BrainCOGS/VRrigs-documentation/README.md

# BrainCOGS VR rigs documentation site
## Setting up a development environment
