BrainCOGS/VRrigs-documentation/index.md

---
layout: home
hero:
  name: BRAIN CoGS
  text: Mini VR Rigs
  tagline: How to build, maintain and run the mini virtual reality rigs at Princeton BRAIN CoGS.
  image:
    src: /images/braincogslogo.png
    alt: BRAIN CoGS
  actions:
    - text: Build a Rig
      link: /building/
      theme: brand
    - text: Maintenance
      link: /maintenance/
      theme: alt
    - text: Software
      link: /software/
      theme: alt
features:
  - icon: 🛠️
    title: Build a Mini VR Rig
    details: Parts lists, CAD files and step-by-step assembly for every module, from the cabinet to lick detection.
    link: /building/
    linkText: Start building
  - icon: 🔧
    title: Maintain a Mini VR Rig
    details: Calibrate the projection, reward and stage, and keep each module of the rig running.
    link: /maintenance/
    linkText: Maintenance guides
  - icon: 💻
    title: Software
    details: Database access, ViRMEn, the ephys/imaging automation pipeline, alerts and scheduled jobs.
    link: /software/
    linkText: Software guides
---
