BrainCOGS/VRrigs-documentation/software/automation_pipeline.md

---
title: Ephys/Imaging Automation Pipeline
lang: en-US
---

# {{ $frontmatter.title }}

## Data Folders

The ephys and imaging pipelines use the following data folder structures:

- **Raw Data Directory Imaging:** braininit/Data/Raw/imaging/(user)/(subject)/(session_date)_g(session#)/(user_defined_dir)
- **Processed Data Directory Imaging:** braininit/Data/Processed/imaging/(user)/(subject)/(session_date)_g(session#)/(user_defined_dir)/job_id_(jobid)/suite2p_output/suite2p
- **Raw Data Directory Ephys:** braininit/Data/Raw/electrophysiology/(user)/(subject)/(session_date)_g(session#)/(g#_spikeglx_dir)/(imec#_spikeglx_dir)
- **Processed Data Directory Ephys:** braininit/Data/Processed/electrophysiology/(user)/(subject)/(session_date)_g(session#)/(g#_spikeglx_dir)/(imec#_spikeglx_dir)/job_id_(jobid)/(sorter)_output

## Initial configuration

Note: These steps are only needed if a red label reading "Configuration needed" appears in the top-right corner of the GUI.

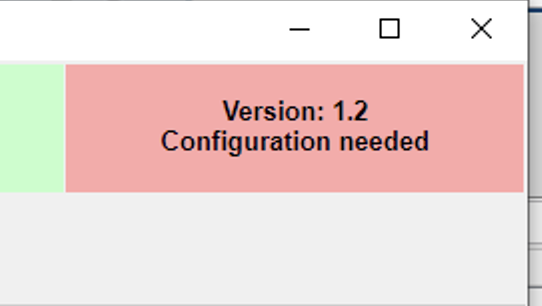
[picture p1: software/assets/images/automation_gui/Configuration_needed_label.png]
Configuration needed label
  

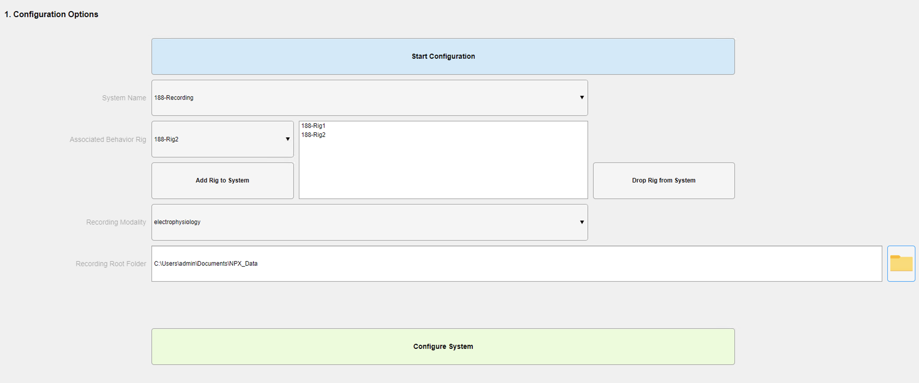
[picture p2: software/assets/images/automation_gui/Configuration_screen.png]
Configuration screen
  

1. Switch to the **"System Configuration"** tab.
2. Click the **"Start Configuration"** button.
3. In the **"System Name"** dropdown, select the corresponding system (normally named room#-Recording#).
4. In the **"Associated Behavior Rig"** dropdown, select the corresponding rig paired with the recording system.
5. Click the **"Add Rig to System"** button.
6. Repeat steps 4 and 5 until all rigs associated with the recording system are added.
7. In the **"Recording Modality"** dropdown, select the corresponding modality of the recording system.
8. In the **"Recording Root Folder"** area, click the folder button to search for the parent path where all recordings will be stored.
9. Click the **"Configure System"** button.

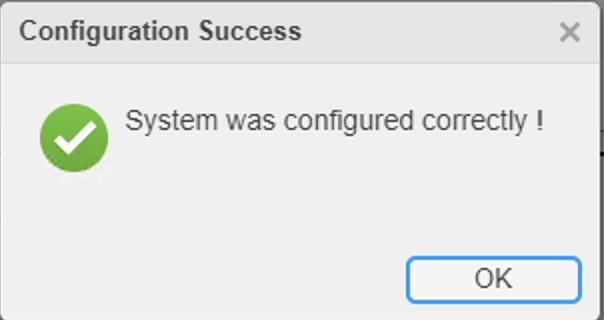
[picture p3: software/assets/images/automation_gui/System_configured_dialog.png]
System configured correctly
  

If something was configured incorrectly, you can repeat the entire process.

## Automation GUI "regular use" Manual

- The automation GUI is located on the desktop of every microscope/ephys recording system across BRAIN CoGS. You can identify it by the BRAIN CoGS desktop icon called "Recording_Automation_GUI".
- We encourage you to register and process every recording with the Automation GUI as soon as the recording ends.

### Default use case

1. Open the GUI as soon as the recording ends.
2. Select the recording directory from the dropdown list in section 1.
   - If no behavior is associated with this recording, uncheck the **Is there behavior Session for Recording** checkbox.
3. Check the "Add surgery & insertion device if missing" checkbox if you want to add electrode/microscope/optic fiber insertion coordinates.
4. Select the behavior session corresponding to the recording from the dropdown list in section 2.
5. Click the **Register Recording** button.

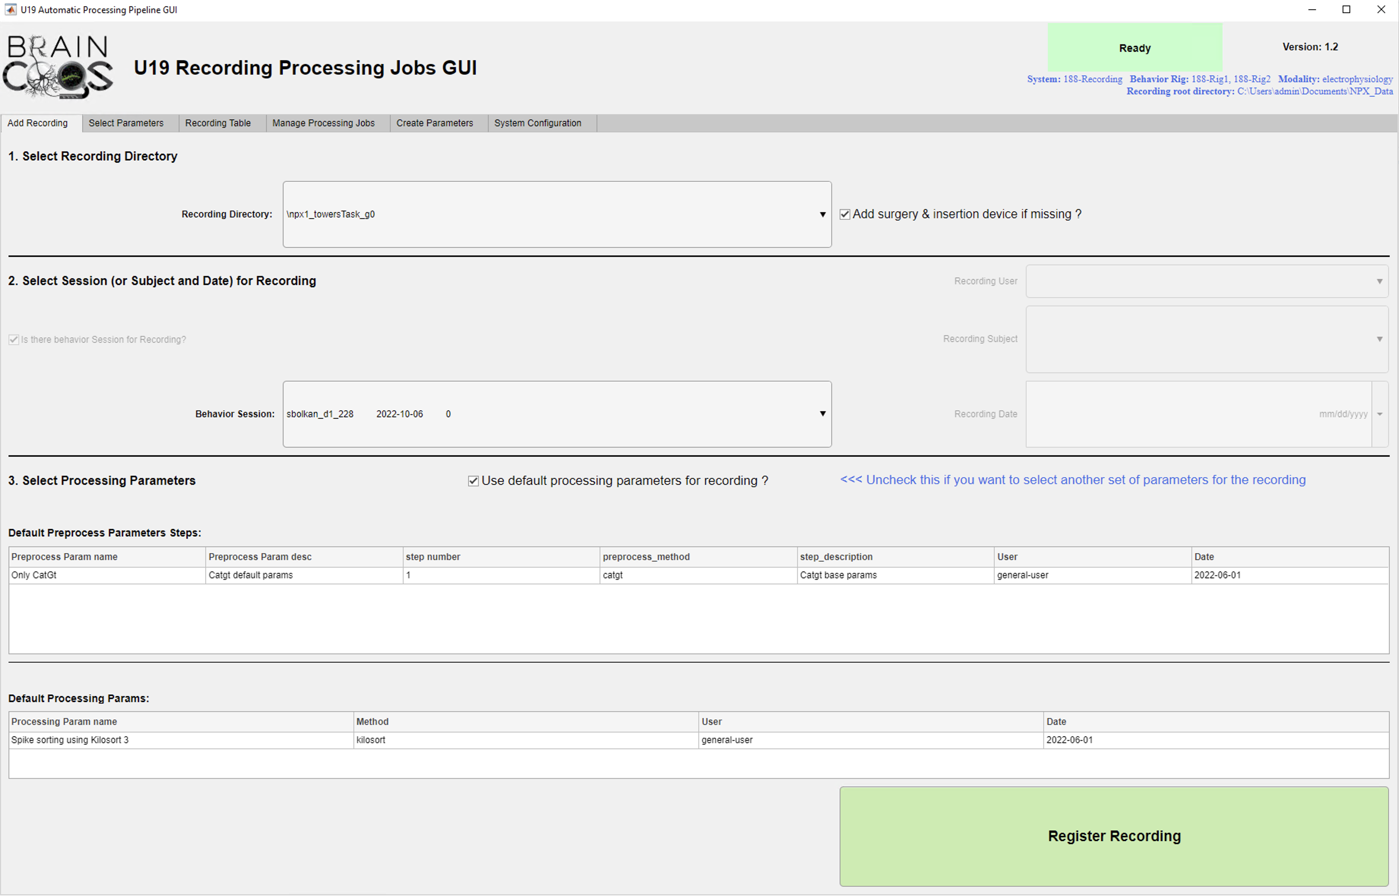
[picture p4: software/assets/images/automation_gui/Automation_GUI_main_screen.png]
Automation GUI main screen
  

- If no surgery data is found for the subject, a small form for entering surgery and device insertion coordinates appears.

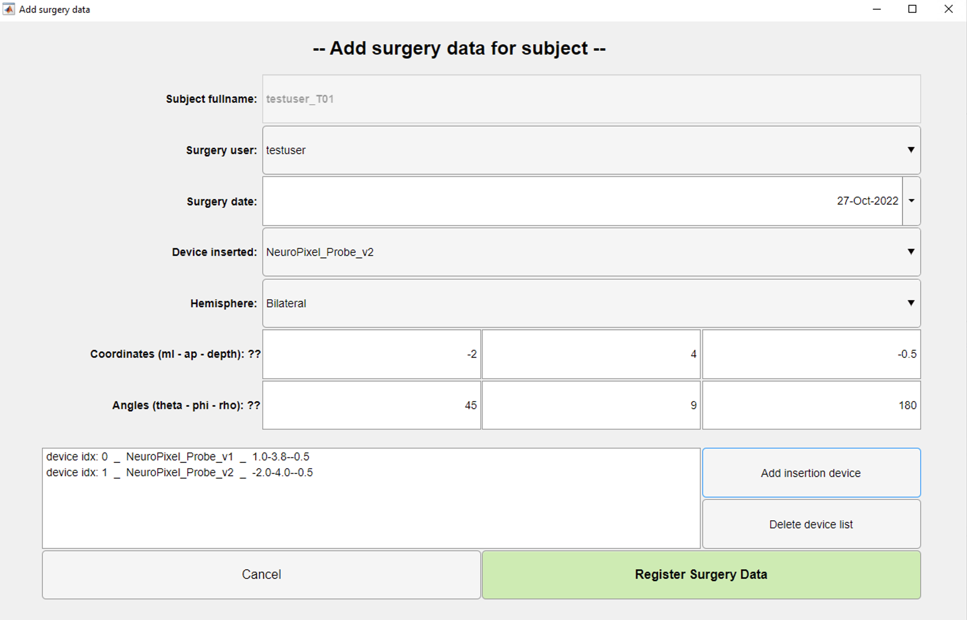
[picture p5: software/assets/images/automation_gui/Add_surgery_data.png]
Add surgery data form
  

- Common coordinates for previous recordings:

| **Area** | ml(mm) | ap(mm) | depth(mm) | theta(°) | phi(°) | rho(°) |
|---:|---:|---:|---:|---:|---:|---:|
| **mPFC L HEMIS** | -0.6 | 1.8 | 3.8 | -45 | -9 | 180 |
| **mPFC R HEMIS** | 0.6 | 1.8 | 3.8 | 45 | 9 | 0 |
| **HPC  L HEMIS** | -1.5 | 2 | 1.8 | -45 | -9 | 180 |
| **HPC  R HEMIS** | 1.5 | 2 | 1.8 | 45 | 9 | 0 |

- Wait until the recording has been copied to PNI storage resources (cup).

  Dialog shown while copying session

6. After the recording has been transferred, a small dialog showing the recording ID appears.

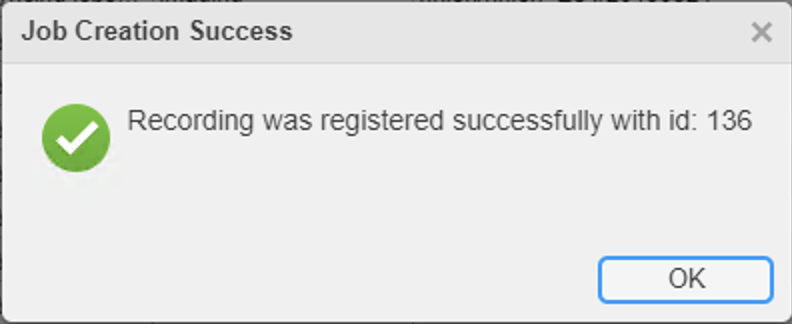
[picture p6: software/assets/images/automation_gui/Recording_registered.png]
Dialog shown when recording has been transferred
  

7. You can check basic info about the new recording in the "Recording Table" tab. This tab becomes active after the recording is transferred.

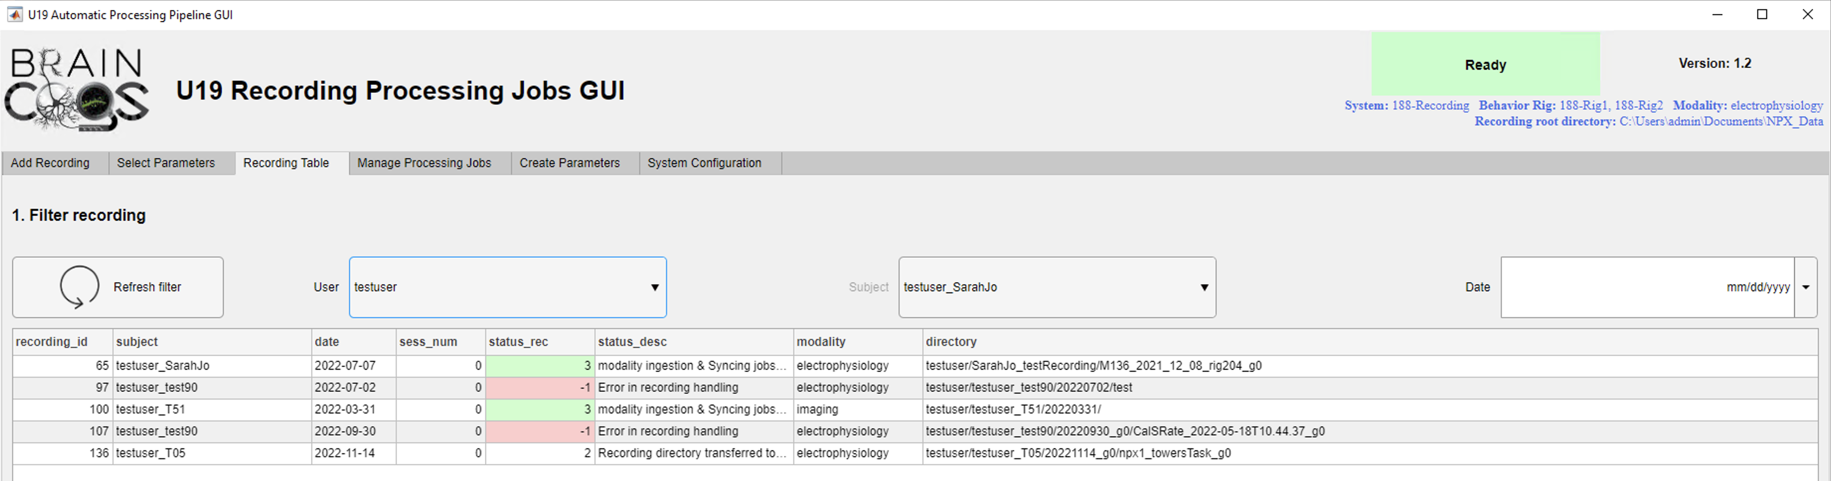
[picture p7: software/assets/images/automation_gui/Recording_table.png]
Recording table tab screenshot
  

#### Notes

- This use case assumes the recording will be processed with default parameters.

## "Advanced" (select parameters) use case

1. Follow steps 1-4 from the **Default use** case.
2. Uncheck the **"Use default processing parameters for recording?"** checkbox.
3. Click the **"Select parameters >>>"** button.

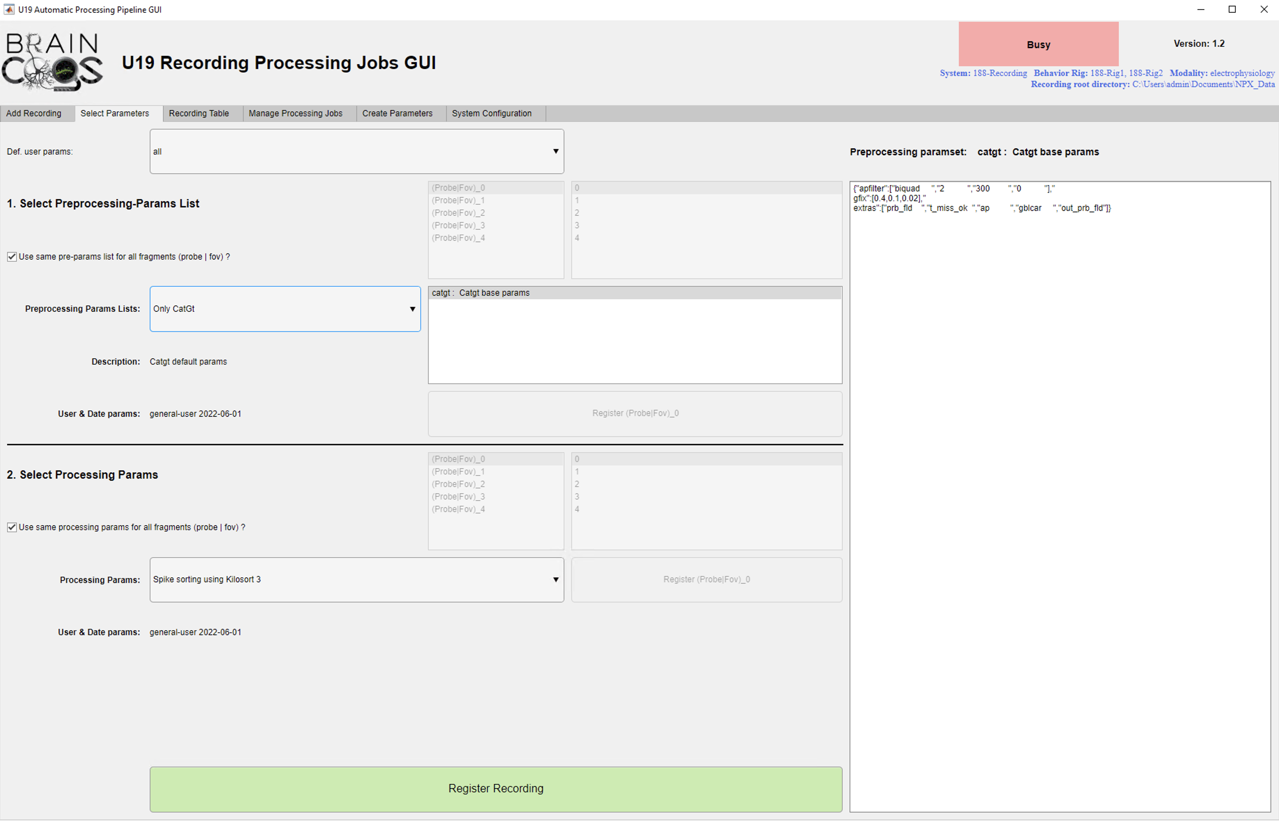
[picture p8: software/assets/images/automation_gui/Select_parameters.png]
Parameter selection main screen
  

4. On the **"Select parameters"** tab (assuming all probes/FOVs will be processed with the same parameters):

### On section 1:

5. In the **Preprocessing Params Lists** dropdown, select a preprocessing param list.
   - You can see which preprocessing steps are defined for that list in the listbox on the right.
   - Selecting a preprocessing step in the listbox shows its specific parameters in the text area on the right.

### On section 2:

6. In the **Processing Params** dropdown, select a processing parameter set suited to the recording.
   - Selecting a processing parameter set from the dropdown shows its specific parameters in the text area on the right.
7. Click the **Register Recording** button.

The next steps are identical to the **"Default use"** case.

## Monitor jobs

- After a recording is submitted for processing, you can track, reprocess, and visualize all jobs corresponding to that recording.

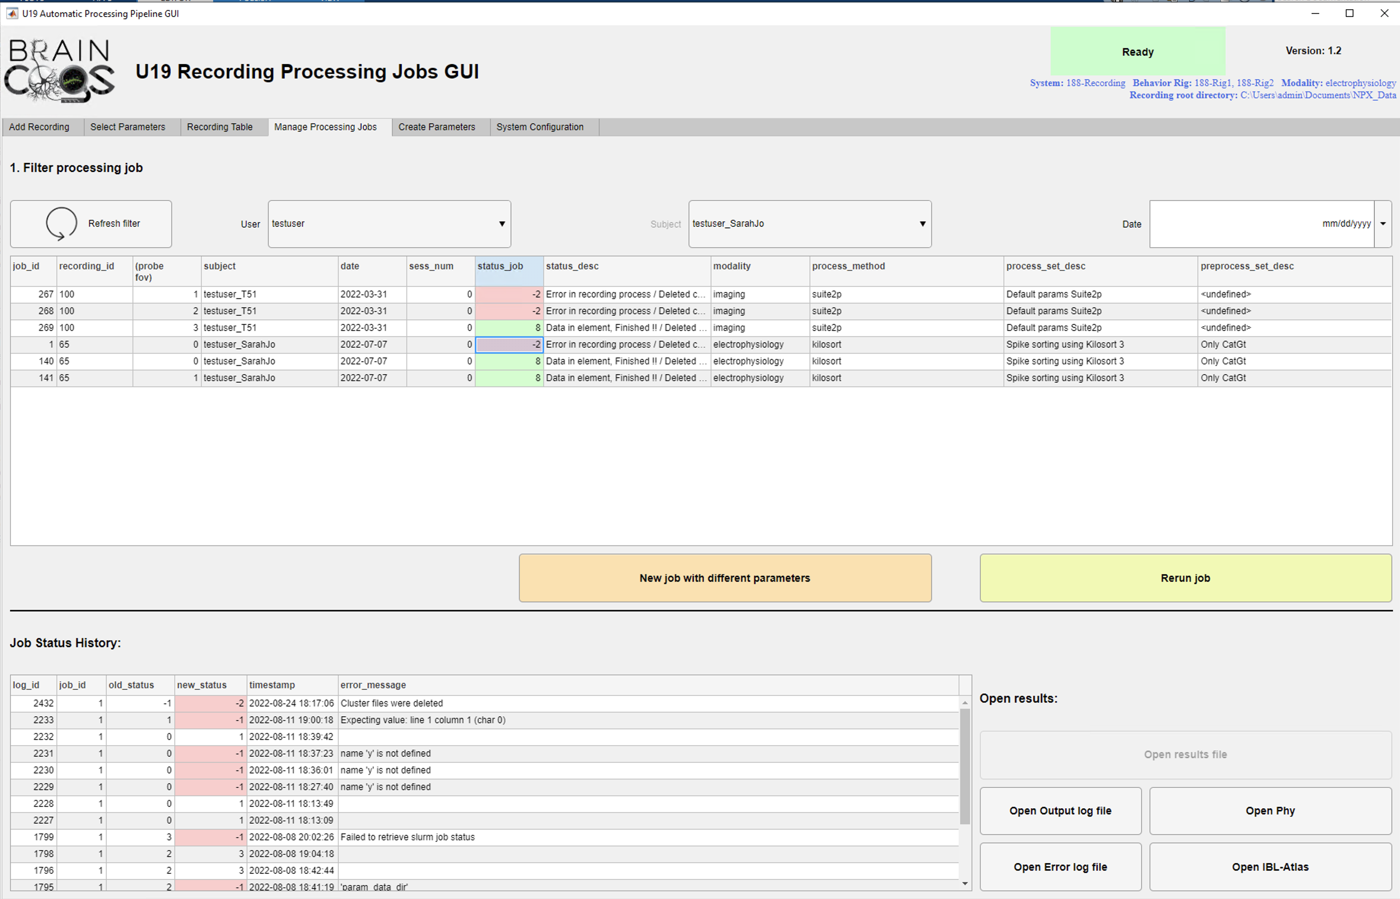
[picture p9: software/assets/images/automation_gui/Job_table.png]
Manage Processing Jobs main screen
  

### Track status

1. Switch to the **"Manage Processing Jobs"** tab.
2. Use the **"User"**, **"Subject"**, and **"Date"** dropdowns/fields to find the desired jobs.
3. Select the row corresponding to the desired job:

- The job status history is shown for the selected job.

#### If the job is in an error status (-1, -2; "Error in recording process"): {#if-status-of-job-is-in-error-status-1-2-error-in-recording-process}

- Open the error log file in the bottom-right corner by clicking the **"Open Error Log File"** button.
- If you believe the cause of the error is now resolved, rerun the job by clicking the **"Rerun job"** button.

#### If the job is in a finished status (7, 8; "Data in element DB"): {#if-status-of-job-is-in-finished-status-7-8-data-in-element-db}

- Open the output log file in the bottom-right corner by clicking the **"Open Output Log File"** button.
- Visualize processing results by clicking the bottom-right buttons: **Open Phy** and **Open IBL Atlas** for ephys, **Open Suite2p-GUI** for imaging.

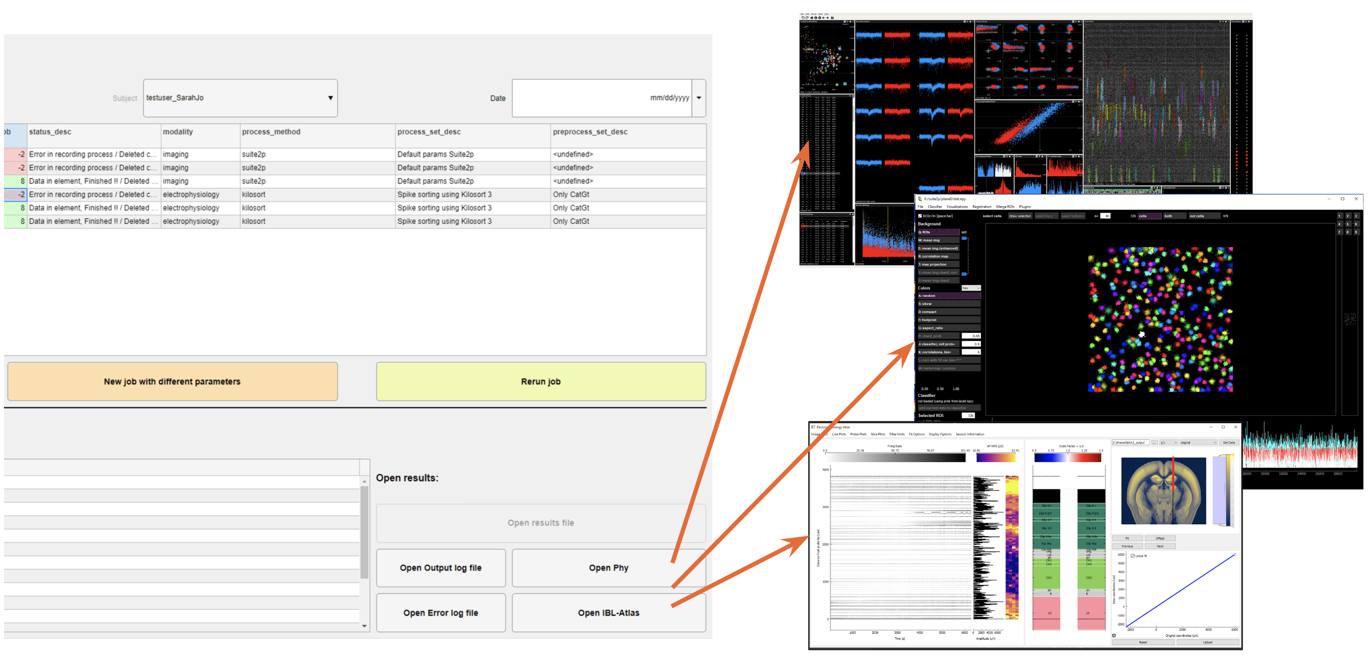
[picture p10: software/assets/images/automation_gui/Processing_visualization.png]
Visualization tools available
  

#### Rerun jobs

- You can rerun a job with different parameters by clicking the **New Job With different Parameters** button.
- Follow the <a href='/software/automation_pipeline.html#advanced-select-parameters-use-case'> "Advanced" (select parameters) use case </a>.

## Create new sets of processing parameters for recordings

To process recordings with non-default parameters, you need at least one of the following:

1. A new set of processing parameters (parameters for the algorithm that processes the data, e.g. Kilosort, Suite2p).
2. A list of preprocessing steps, each with its own set of preprocessing parameters (e.g. run CatGT + TPrime before Kilosort).

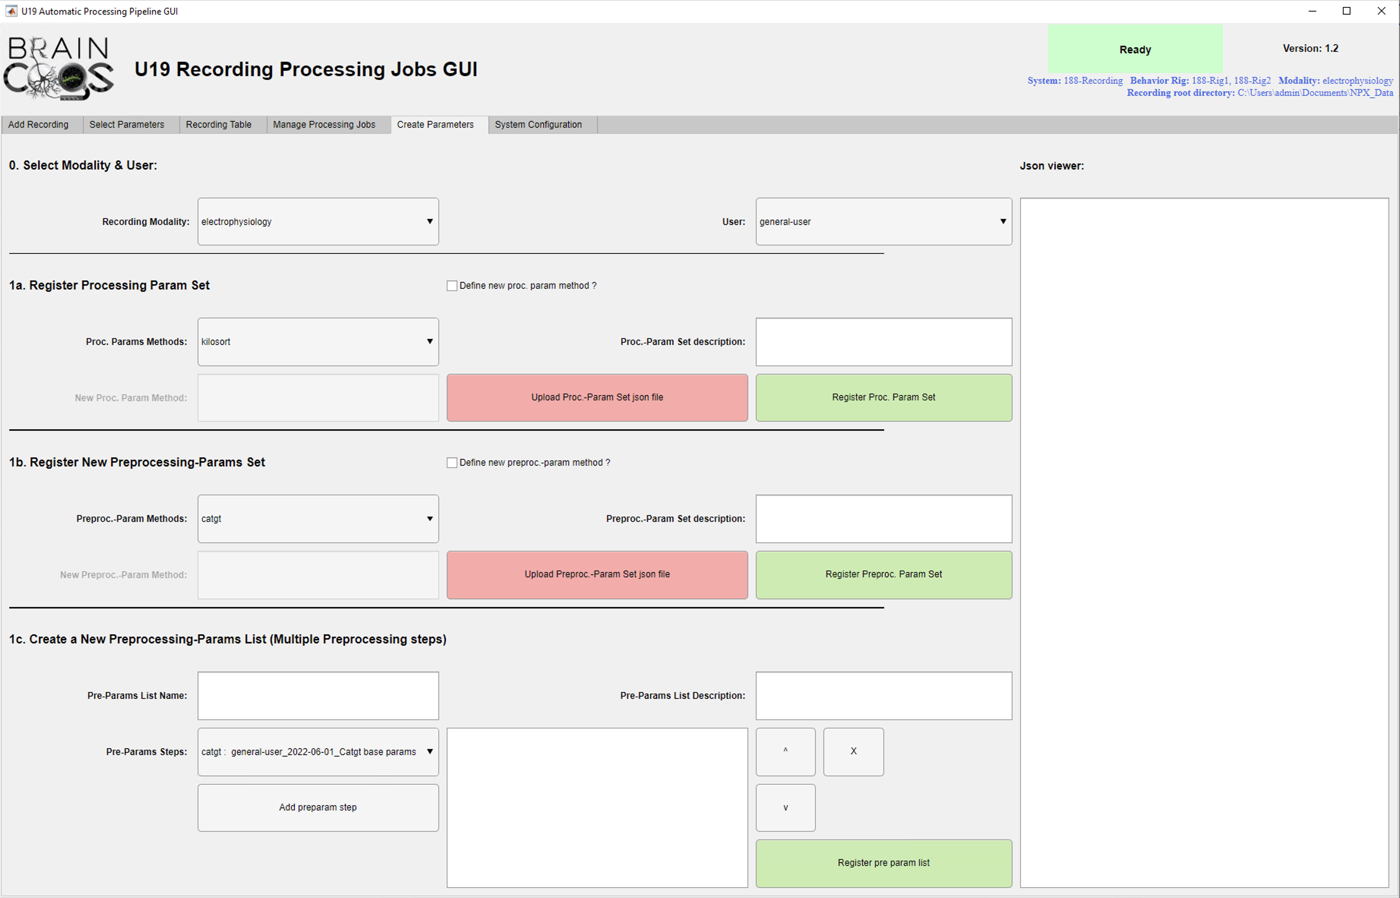
[picture p11: software/assets/images/automation_gui/Create_parameters_screen.png]
Create parameters screen
  

### Create new Processing parameters (algorithm params)

- Note: You need a JSON file with all parameters ready before starting this process.
- <a href='./assets/files/automation_gui/kilosort_parameters_example.json.zip'>Here</a> is an example Kilosort parameter JSON file that you can use as a template for your own.

1. Switch to the "Create Parameters" tab.

#### On section 0:

2. In the "recording modality" dropdown, select which modality the parameters correspond to.
3. In the "user" dropdown, select your NETID username (select general-user if this parameter will be shared by many users).

#### On section 1a:

4. In the "proc. Param Method" dropdown, select which method (algorithm) these parameters refer to.

##### If the algorithm is not found on "proc. Param Method" dropdown:

- Check the "define new proc. param method ?" checkbox.
- Write the new processing method name in the "New Proc. Param. method" field.
- Check the <a href='/software/automation_pipeline_developer.html#collab-repositories-to-handle-ephys-imaging-processing'>automation pipeline developer guide</a> to add the corresponding processing code.

5. In the "proc. Param Set Description" field, write a short description for the new parameters.
6. Click the "Upload Proc-Parm Set json file" button and browse for/load your JSON file with parameters. You can review your parameters in the text area on the right.
7. Click the "Register Proc. Param Set" button.

### Create new preprocessing parameters (a single step on preprocessing list)

- Note: You need a JSON file with all parameters ready before starting this process.
- <a href='./assets/files/automation_gui/catgt_parameters_example.json.zip'>Here</a> is an example CatGT parameter JSON file that you can use as a template for your own.

1. Switch to the "Create Parameters" tab.

### On section 0:

2. In the "recording modality" dropdown, select which modality the parameters correspond to.
3. In the "user" dropdown, select your NETID username (select general-user if this parameter will be shared by many users).

### On section 1b:

4. In the "Preproc.-Param Method" dropdown, select which method (tool) these parameters refer to.

#### If the tool is not found on "Preproc.-Param Method" dropdown:

- Check the "define new prerproc.-param method ?" checkbox.
- Write the new preprocessing method name in the "New Preproc.-Param method" field.
- Check the <a href='/software/automation_pipeline_developer.html#collab-repositories-to-handle-ephys-imaging-processing'>automation pipeline developer guide</a> to add the corresponding processing code.

5. In the "Preproc.-Param Set Description" field, write a short description for the new parameters.
6. Click the "Upload Preproc.-Parm Set json file" button and browse for/load your JSON file with parameters. You can review your parameters in the text area on the right.
7. Click the "Register PreProc. Param Set" button.

### Create new preprocessing parameters list (a set of preprocessing parameters)

- Note: If you just created a preprocessing parameter, restart the GUI.

1. Switch to the "Create Parameters" tab.

### On section 0:

2. In the "recording modality" dropdown, select which modality the parameters correspond to.
3. In the "user" dropdown, select your NETID username (select general-user if this parameter will be shared by many users).

### On section 1c:

4. In the "Pre-Params List Name" field, enter a suitable name for the list.
5. In the "Pre.-Param List Description" field, write a short description for the new list.
6. From the "Pre.-Params steps" dropdown, select the desired preprocessing step to add to the list.
7. Click the "Add Preparam Steps" button.
8. Repeat steps 6 and 7 to add all desired preprocessing steps to the list.
9. Use the "v" and "^" buttons to set the order of the preprocessing steps.
10. Use the "x" button to delete an unwanted preprocessing step.
11. Click the "Register pre param list" button.
