BrainCOGS/VRrigs-documentation/software/manipulation_pipeline.md

---
title: Manipulation pipeline
lang: en-US
---

# {{ $frontmatter.title }}

+ This guide walks researchers through creating a new manipulation pipeline.
+ At BRAIN CoGS, optogenetic and thermal manipulations are currently supported.

## What does the “manipulation” pipeline include? {#what-does-the-manipulation-pipeline-include}

+ A minimal data framework for storing all relevant data from a specific manipulation in a DB.
+ Behavior integration: the training system includes the manipulation as an option that can be selected for a behavior session.
+ Generic software parameters to be used in behavior code.

## Prerequisites

+ To create a new manipulation, you need to:
  + be able to connect to the <a href="/software/db_access.html#db-access-for-matlab-repository">datajoint00.pni.princeton.edu DB</a>, and
  + have the latest version of the U19-pipeline-matlab repository installed.

## Initial setup {#initial-set-up}

+ Connect to the database: `connect_datajoint00`
+ Create the new manipulation schema (replace `manipulation_name` with the actual manipulation name): `create_new_manipulation_schema('(manipulation_name)', 1)`
+ This creates the "base" code for the new schema in the `U19-pipeline-matlab/schemas` directory.
+ (We use the “thermal” manipulation as the example.)

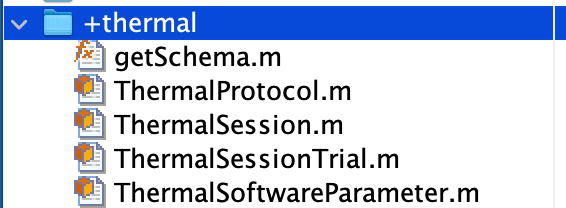
[picture p33: software/assets/images/manipulation_pipeline/Thermal_schema_files.png]
 

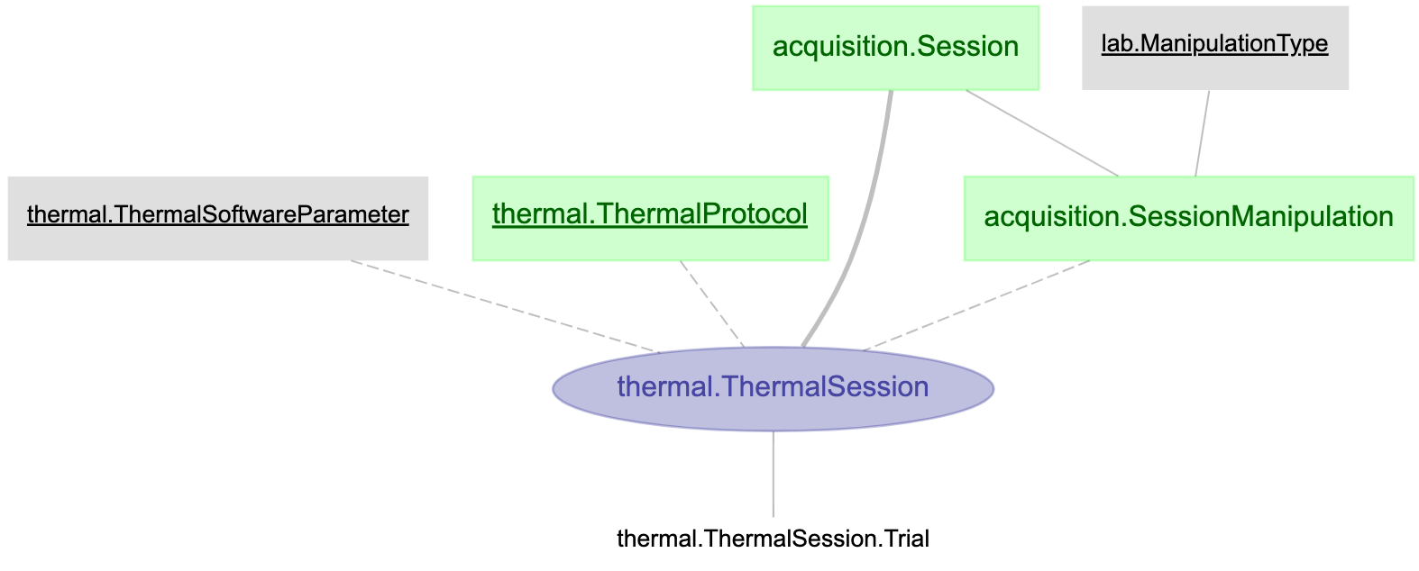
[picture p34: software/assets/images/manipulation_pipeline/Thermal_pipeline_ERD.png]
Thermal manipulation file creation & Entity-Relationship diagram on the BRAIN CoGS DB
 

## Table description

+ Throughout this section, we use an existing, working manipulation pipeline (optogenetics) as the example.

### "Manipulation" Protocol table

  + The Protocol table stores information that defines the current manipulation “type” to be used in a behavior session.
  + Below is the minimal definition of a manipulation protocol table: an id that identifies the protocol, and a description field.

  + Generic **"Manipulation" Protocol.m**
  ```matlab
  %{
  # Defined <manipulation> protocols for training
  <manipulation>_protocol_id     : int AUTO_INCREMENT
  ---
  protocol_description        : varchar(256)  
  %}
  ```

### Adding features to "Manipulation" Protocol table

+ For each manipulation protocol, you can add from 0 to n “features” that define and describe the protocol. As an example, we describe all the features added for **OptogeneticsProtocol**:

+ For an optogenetic experiment, it is important to know what kind of stimulation was given to the subject: frequency, wavelength, power, etc. All these variables can be stored in a “feature” table and categorized as StimulationParameters.
+ What if the stimulation was not a square pulse? We can create a “feature” table to define specific waveforms for a given session, if needed (OptogeneticsWaveform).
+ What if different rooms have different laser system models? We can create a “feature” table to store all the possible devices used in an optogenetic experiment (OptogeneticsDevice).
+ For each of these features, we need to create a new table that holds the information needed for that feature. We call all these extra tables protocol “feature” tables.
+ For a guide on how to define DJ tables, see <a href="https://docs.datajoint.org/matlab/definition/02-Creating-Tables.html">this link</a>.

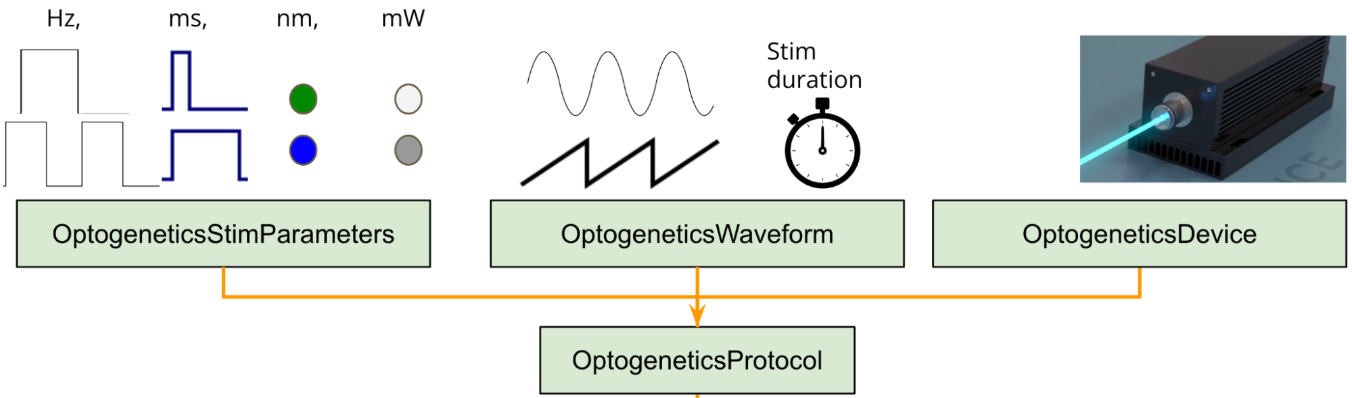
[picture p35: software/assets/images/manipulation_pipeline/Optogenetics_pipeline.png]
Tables that define an optogenetic protocol for a session.
 

+ For this guide, we show only the OptogeneticsStimulationParameters definition as an example:

### OptogeneticsStimulationParameters.m:
 ```matlab
  %{
  # Parameters related to laser stimulation
  stim_parameter_set_id       : int AUTO_INCREMENT  #
  ---
  stim_parameter_description  : varchar(256)        #
  stim_wavelength             : decimal(5,1)        # (nm)
  stim_power                  : decimal(4,1)        # (mW)
  stim_frequency              : decimal(6,2)        # (Hz)
  stim_pulse_width            : decimal(5,1)        # (ms)
  %}

  classdef OptogeneticStimulationParameter < dj.Lookup
    properties
    end
  end
  ```

+ Fields needed for a protocol “feature” table:

+ **id field:** An int AUTO_INCREMENT type as the only primary key (e.g. stim_parameter_set_id).
+ **extra_fields:** Any other field that helps define the feature.
+ Once all the feature tables are defined, they should be added to the "Manipulation" Protocol table.

+ For our Optogenetics example:
 ```matlab
 % Declare new "feature" table
 optogenetics.OptogeneticsStimulationParameters
 % Add the feature -> protocol table
 add_feature_key_protocol_table(optogenetics.OptogeneticsProtocol, ... optogenetics.OptogeneticsStimulationParameters)
 % Sync definition from DB to .m file
 syncDef(optogenetics.OptogeneticsProtocol);
 % clear previous connection and connect again
 clear all
 connect_datajoint00
 ```

+ Once the “feature” tables are added to the "Manipulation" Protocol table, we are ready to add protocols so they are “ready” and selectable for a behavior session:

```matlab
 % Insert stim parameter record
 stim_parameter_rec.stim_parameter_description = 'cool stims'
 stim_parameter_rec.stim_wavelength = 473
 stim_parameter_rec.stim_power = 10  
 stim_parameter_rec.stim_frequency = 100  
 stim_parameter_rec.stim_pulse_width = 1
 insert(optogenetics.OptogeneticsStimulationParameters, stim_parameter_rec)  

 % get last inserted stim_id
 stim_id = fetch(optogenetics.OptogeneticsStimulationParameters, 'ORDER BY stim_parameter_set_id desc LIMIT 1');

 % or look for a previously inserted parameter
 all_stim_params = fetch(optogenetics.OptogeneticsStimulationParameters, '*')
 stim_id = 1;

 % Insert new protocol with new stimulation parameter
 new_protocol.protocol_description = 'this_is_new_protocol'
 new_protocol.stim_parameter_set_id = stim_id;
 insert(optogenetics.OptogeneticsProtocol, new_protocol)
```  

### "Manipulation" SoftwareParameters table

+ The SoftwareParameters table stores a set of parameters (a MATLAB struct or a Python dictionary) that the code handling the behavior uses during the session.
+ Below is how to insert new software parameters into the **optogenetics.OptogeneticSoftwareParameter** table.

 ```matlab
 param_struct = struct();
 param_struct.software_parameter_description =  'stimulation_sequence # 1';

 % All parameters goes in here
 %(P_on and lsrepoch are the common and needed for current opto experiments)
 param_struct.software_parameters.P_on      = 0.21;
 param_struct.software_parameters.lsrepoch  = 'cue';

 %Insert parameter
 software_param_id = try_insert(optogenetics.OptogeneticSoftwareParameter, param_struct)
 ```

+ See the <a href="https://github.com/BrainCOGS/U19-pipeline-matlab/blob/master/scripts/insert_software_parameters/insert_optogenetic_software_parameter.m">insert_optogenetic_software_parameter</a> script to use as an example.
+ To read the software parameters in the ViRMEn experiment code, for example in `initializationCodeFun`:

 ```matlab
 function vr = initializationCodeFun(vr)

 vr.software_params     = vr.exper.userdata.trainee.softwareParams.software_parameters;
 vr.lsrepoch = vr.software_params.lsrepoch;
 vr.P_on = vr.software_params.P_on;
 ```

### "Manipulation" Session table

+ This table stores manipulation data for a specific behavior session. It “links” a manipulation protocol and manipulation software parameters to a behavior session.
+ This table does not need any additional code (unless extra fields from the behavior file need to be stored). **If you need that, contact the DB designer.**

 ```matlab
 OptogeneticSession.m
 %{
 # Information of a optogenetic session
 -> acquisition.Session
 ---
 -> acquisition.SessionManipulation
 -> optogenetics.OptogeneticProtocol
 -> optogenetics.OptogeneticSoftwareParameter
 %}
 ```

### "Manipulation" SessionTrial table

+ This table stores data, on a trial-by-trial basis, corresponding to the manipulation performed during the behavior session.
+ Every "Manipulation" SessionTrial class has a section in its `get_manipulation_trial_data` function where the researcher adds the lines that fetch the manipulation data for each trial:

Code extract from the **OptogeneticSessionTrial** table:

```matlab
function trial_structure = get_manipulation_trials_data(~,session_key, log)
.
.
for itrial = 1:nTrials

  curr_trial = log.block(iBlock).trial(itrial);  
  trial_data = session_key;
  trial_data.stim_on           = curr_trial.lsrON;
  trial_data.t_stim_on  = time_trial(curr_trial.iLaserOn);
  trial_data.stim_epoch = num2str(curr_trial.LaserTrialType);
  trial_structure(total_trials) = trial_data;
```

### Training with a new manipulation {#training-with-new-manipulation}

+ Once all the code for the new manipulation has been set up, the researcher can select the manipulation type, protocol and software parameters in an animal's training schedule, and subsequent behavior sessions will use them.

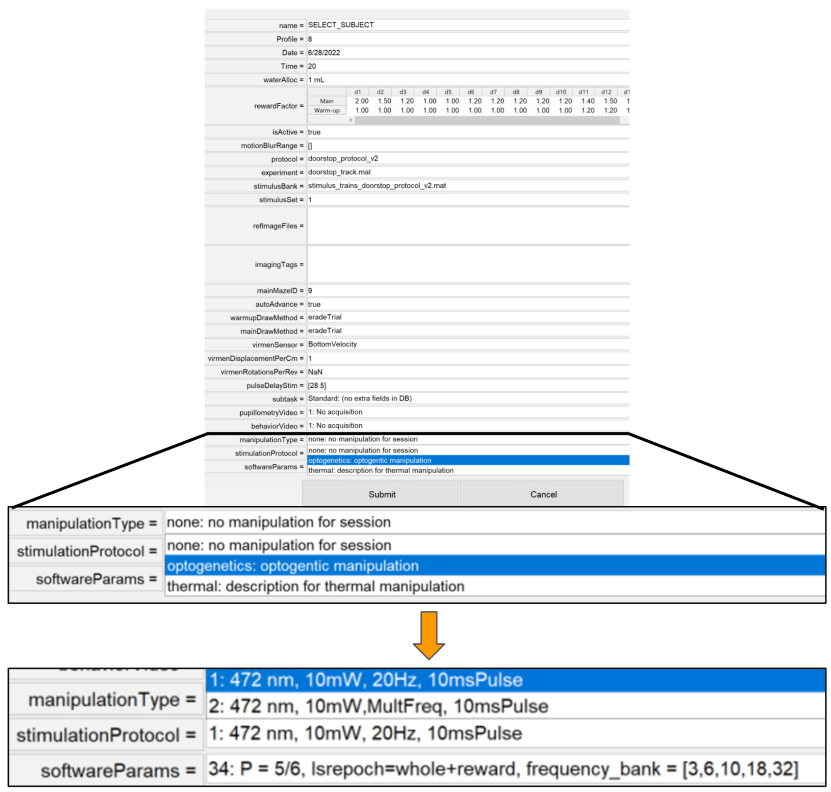
[picture p36: software/assets/images/manipulation_pipeline/manipulation_trainingGUI.png]
Parameter selection (manipulation, protocol & software parameters) for a training schedule of a subject.


### Fetching data {#fetching-data}

+ After training, all relevant data is available in the corresponding tables of the database.
+ <a href="https://docs.datajoint.org/matlab/queries/03-Fetch.html">DataJoint fetch guide</a>

```matlab
key = struct('subject_fullname', 'sbolkan_a2a_492', 'session_date', '2022-06-27')
fetch(optogenetics.OptogeneticSessionTrial * optogenetics.OptogeneticSession & key,'*')

ans =

  363×1 struct array with fields:

    subject_fullname
    session_date
    session_number
    block
    trial_idx
    stim_on
    t_stim_on
    t_stim_off
    stim_epoch
```
