BrainCOGS/VRrigs-documentation/building/assets/3d-printing/positioning/positioning_tool_mini_vr.stp

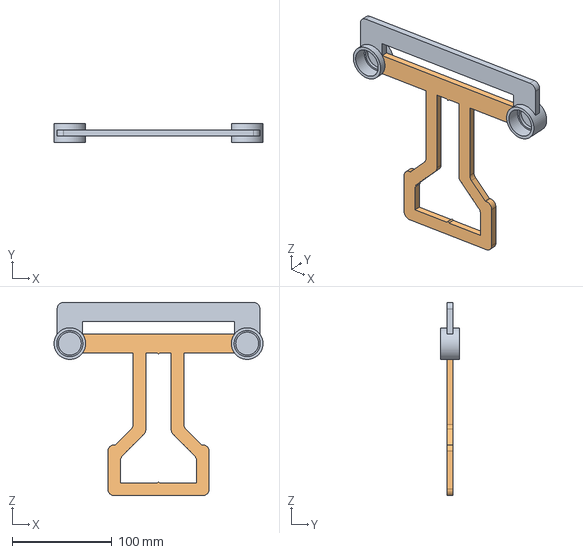
[picture p42: CAD file, 2021-09-08]
building/assets/3d-printing/positioning/positioning_tool_mini_vr.stp
209.5 x 19.0 x 193.6 mm
