BrainCOGS/VRrigs-documentation/(list of files, cad)

Other CAD files:
building/assets/drawings/src/air-puffs/Air puffs delivery.iam
building/assets/drawings/src/air-puffs/Air puffs.iam
building/assets/drawings/src/air-puffs/Control manifold.iam
building/assets/drawings/src/air-puffs/Parts/1162T370_ZINC PLATED STEEL FITTINGS WITH SEALANT.ipt
building/assets/drawings/src/air-puffs/Parts/2227T21_Miniature Precision Compressed Air Regulator.ipt
building/assets/drawings/src/air-puffs/Parts/2227T41_Mounting Bracket for Inline Mount 1 8 NPT Miniature Precision Compressed Air Regulator.ipt
building/assets/drawings/src/air-puffs/Parts/2227T420_PRECISION NPT THREAD MINIATURE AIR REGULATOR.ipt
building/assets/drawings/src/air-puffs/Parts/2844K110_NICKEL-PLTD BRASS BARBED VACUUM TUBE FITTING.ipt
building/assets/drawings/src/air-puffs/Parts/5047K110_MOISTURE-RESISTANT ACETAL BARBED TUBE FITTING(1).ipt
building/assets/drawings/src/air-puffs/Parts/5648K266_POLYURETHANE TUBING FOR WATER.ipt
building/assets/drawings/src/air-puffs/Parts/5779K115_PUSH-TO-CONNECT TUBE FITTING FOR AIR.ipt
building/assets/drawings/src/air-puffs/Parts/5779K117_PUSH-TO-CONNECT TUBE FITTING FOR AIR.ipt
building/assets/drawings/src/air-puffs/Parts/8961K106_MOUNTING ADAPTERS FOR DIN RAIL(1).ipt
building/assets/drawings/src/air-puffs/Parts/91771A919_Passivated 18-8 Stainless Steel Phillips Flat Head Screw.ipt
building/assets/drawings/src/air-puffs/Parts/Manifold for gems solenoid valve vertical.ipt
building/assets/drawings/src/air-puffs/Parts/air puffs delivery cover.ipt
building/assets/drawings/src/air-puffs/Parts/air puffs delivery.ipt
building/assets/drawings/src/positioning/Parts/5862K163_HIGH-PULL RARE EARTH MAGNETIC DISC.ipt
building/assets/drawings/src/positioning/Parts/98535A136_1095 SPRING STEEL MACHINE KEY STOCK.ipt
building/assets/drawings/src/positioning/Parts/Positioning tool mini VR.ipt
building/assets/drawings/src/positioning/Positioning tool mini VR.iam
building/assets/drawings/src/reward/Parts/4406T110_MINIATURE STAINLESS STEEL BARBED TUBE FITTING.ipt
building/assets/drawings/src/reward/Parts/51525K428_PLASTIC QUICK-TURN TUBE COUPLING.ipt
building/assets/drawings/src/reward/Parts/91251A194_Black-Oxide Alloy Steel Socket Head Screw.ipt
building/assets/drawings/src/reward/Parts/Stainless steel tube.ipt
building/assets/drawings/src/reward/Parts/Syringe Needle, With Luer - White-17Gauge.ipt
building/assets/drawings/src/reward/Parts/TR2-Step.ipt
building/assets/drawings/src/reward/Parts/TRB1-Step.ipt
building/assets/drawings/src/reward/Parts/Tube to TRB1 adapter.ipt
building/assets/drawings/src/reward/Reward spout.iam
