BrainCOGS/VRrigs-documentation/building/assets/images/air-puffs/air-puffs-delivery.png

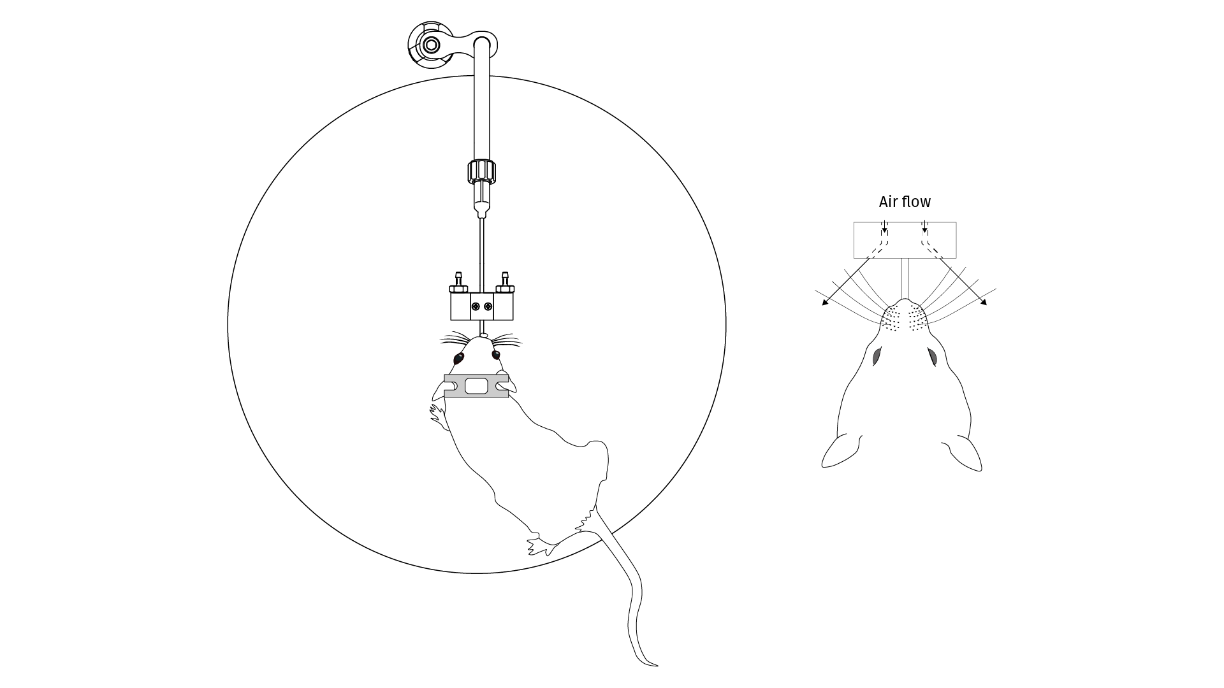
building/assets/images/air-puffs/air-puffs-delivery.png
