BrainCOGS/VRrigs-documentation/building/assets/images/air-puffs/air-puffs-description.png

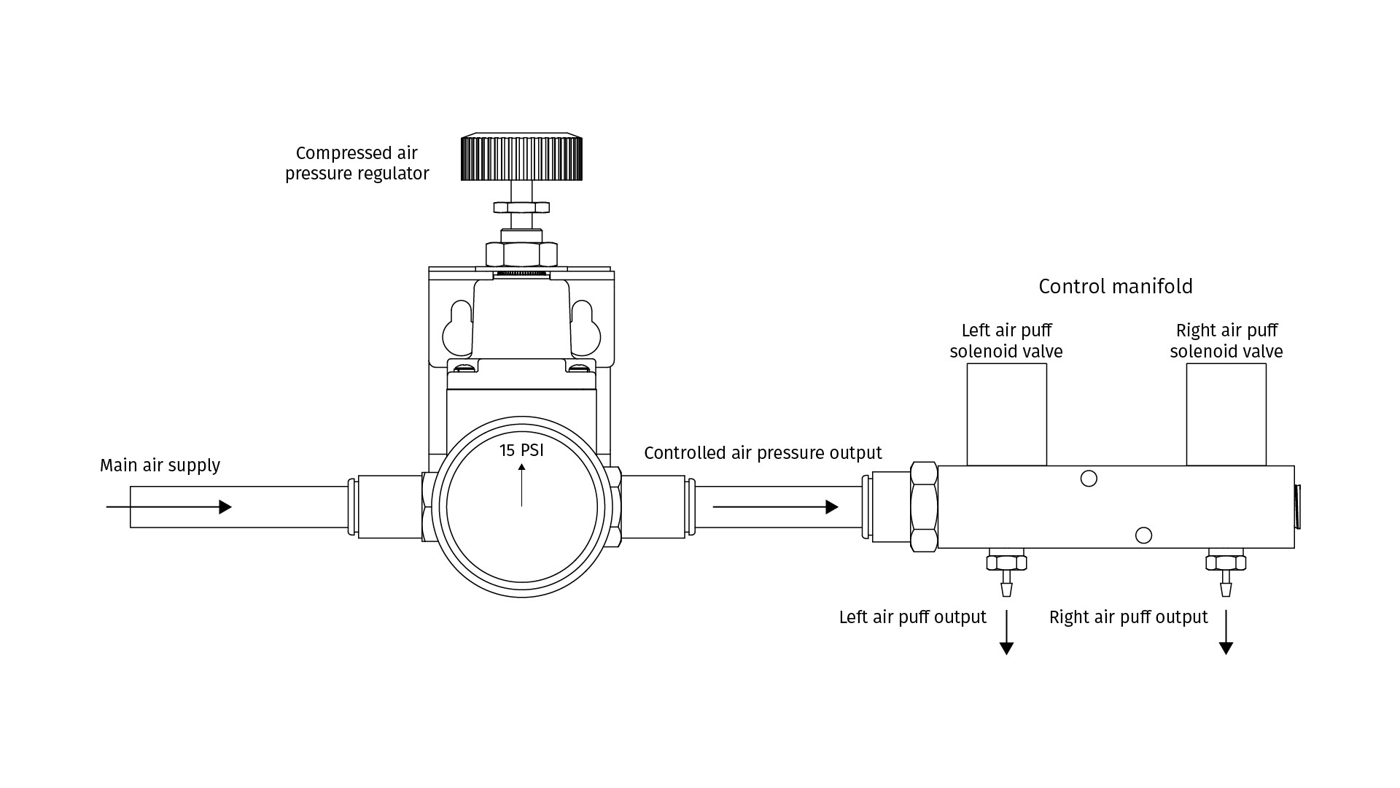
building/assets/images/air-puffs/air-puffs-description.png
