BrainCOGS/VRrigs-documentation/building/assets/images/positioning/positioning-assembly-1.png

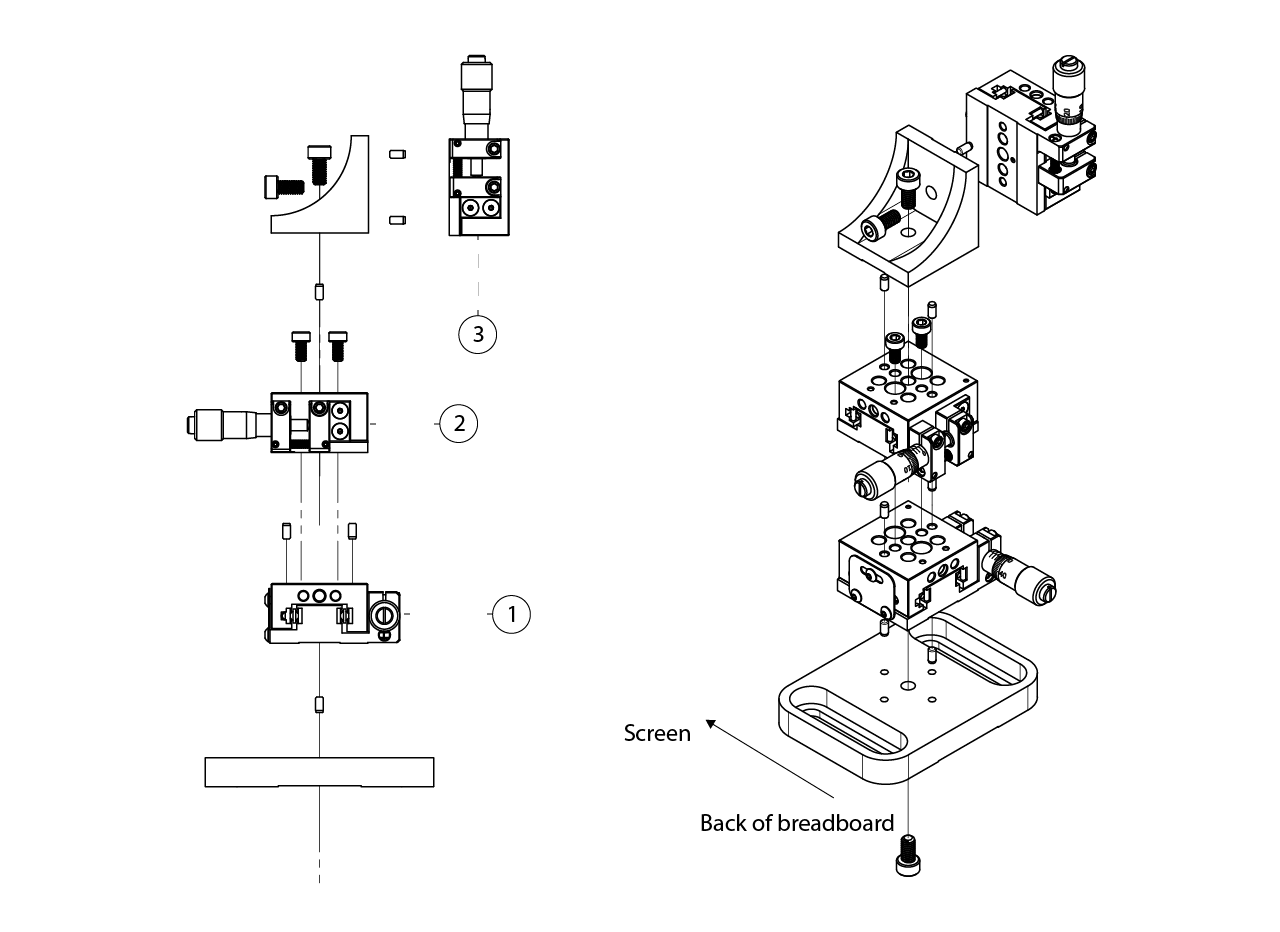
building/assets/images/positioning/positioning-assembly-1.png
