BrainCOGS/VRrigs-documentation/building/assets/images/positioning/positioning-assembly-2.png

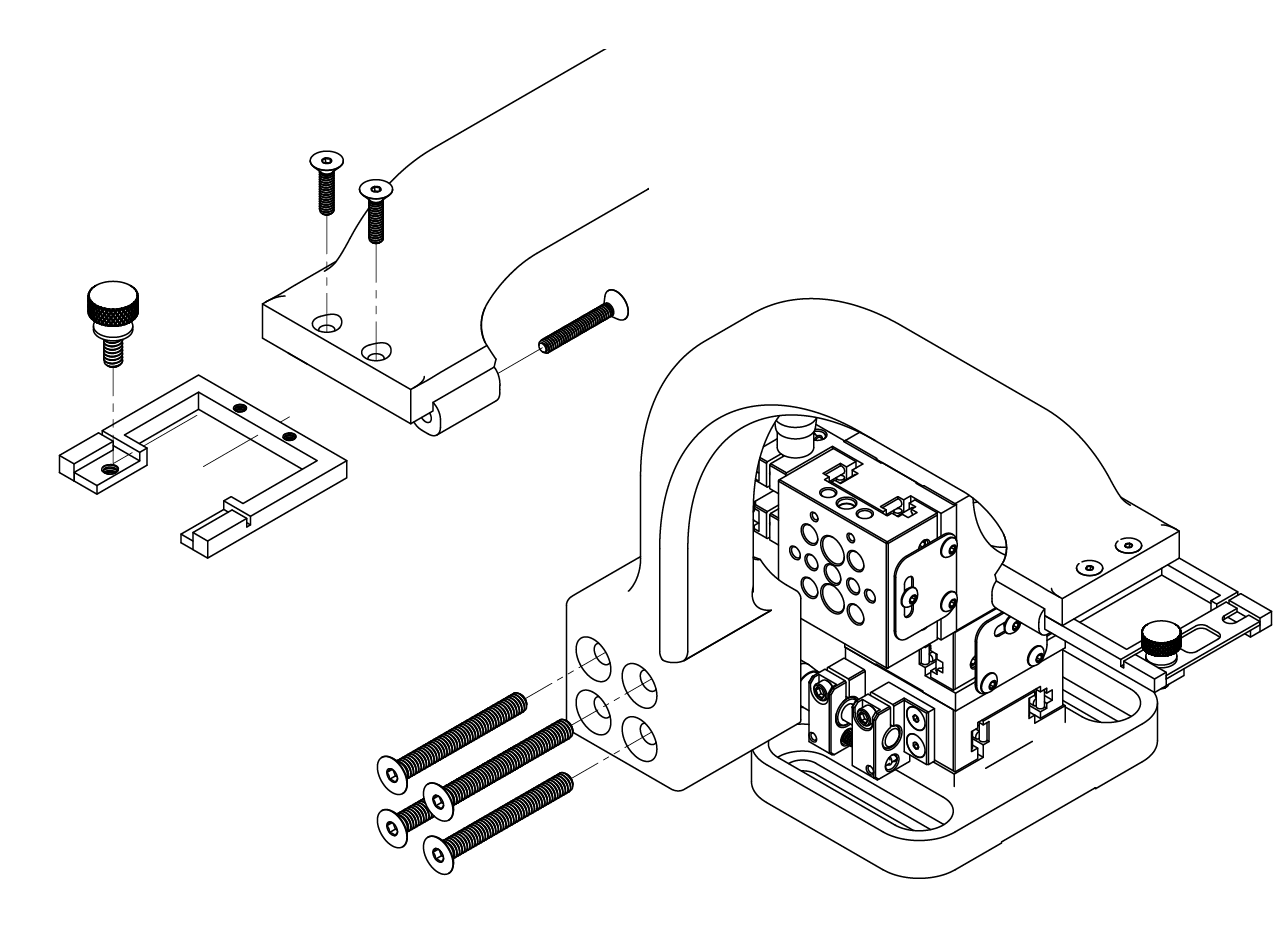
building/assets/images/positioning/positioning-assembly-2.png
