BrainCOGS/VRrigs-documentation/building/assets/images/positioning/positioning-assembly-3.png

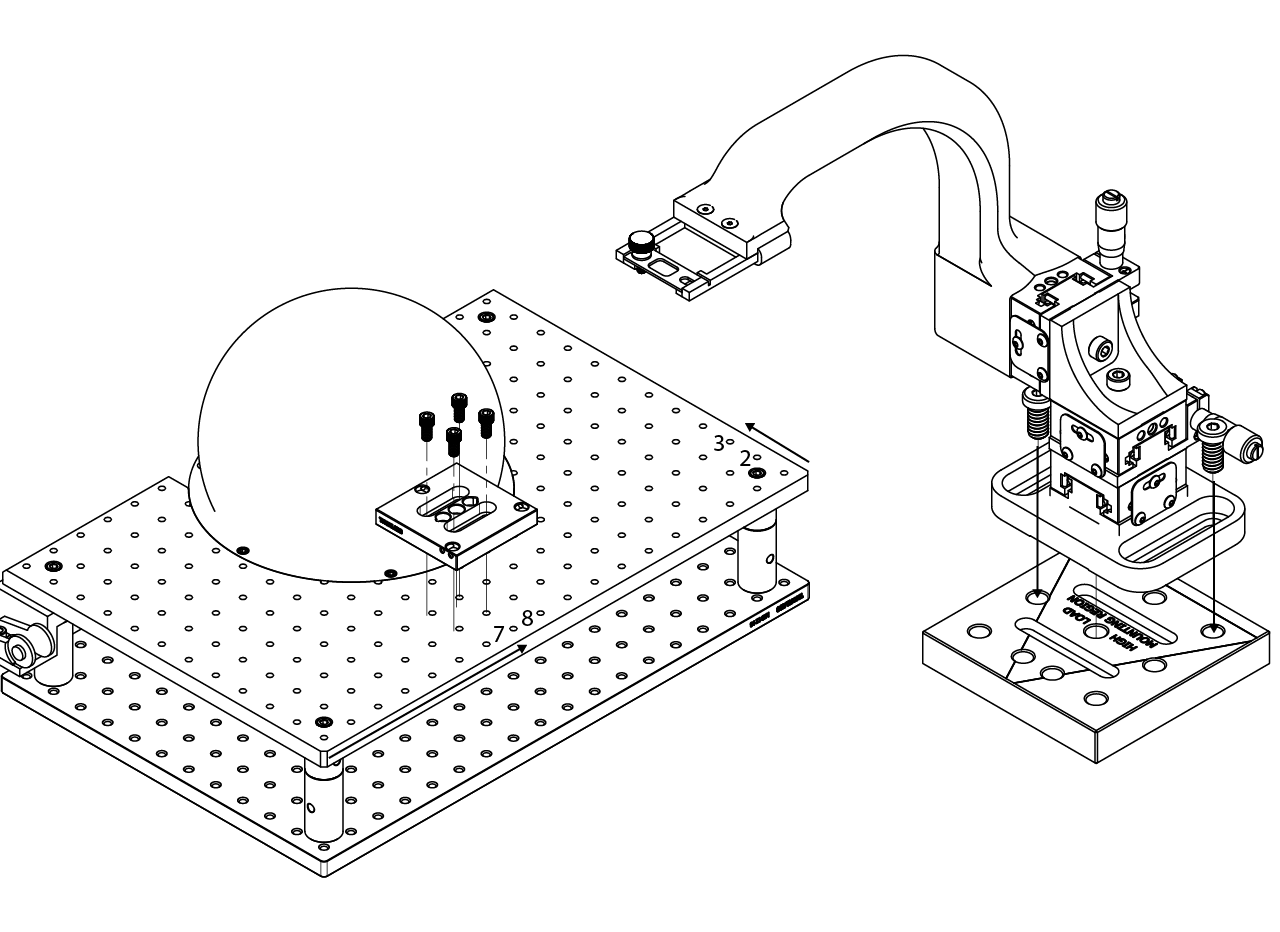
building/assets/images/positioning/positioning-assembly-3.png
