BrainCOGS/VRrigs-documentation/building/assets/images/reward/reward-assembly-1.png

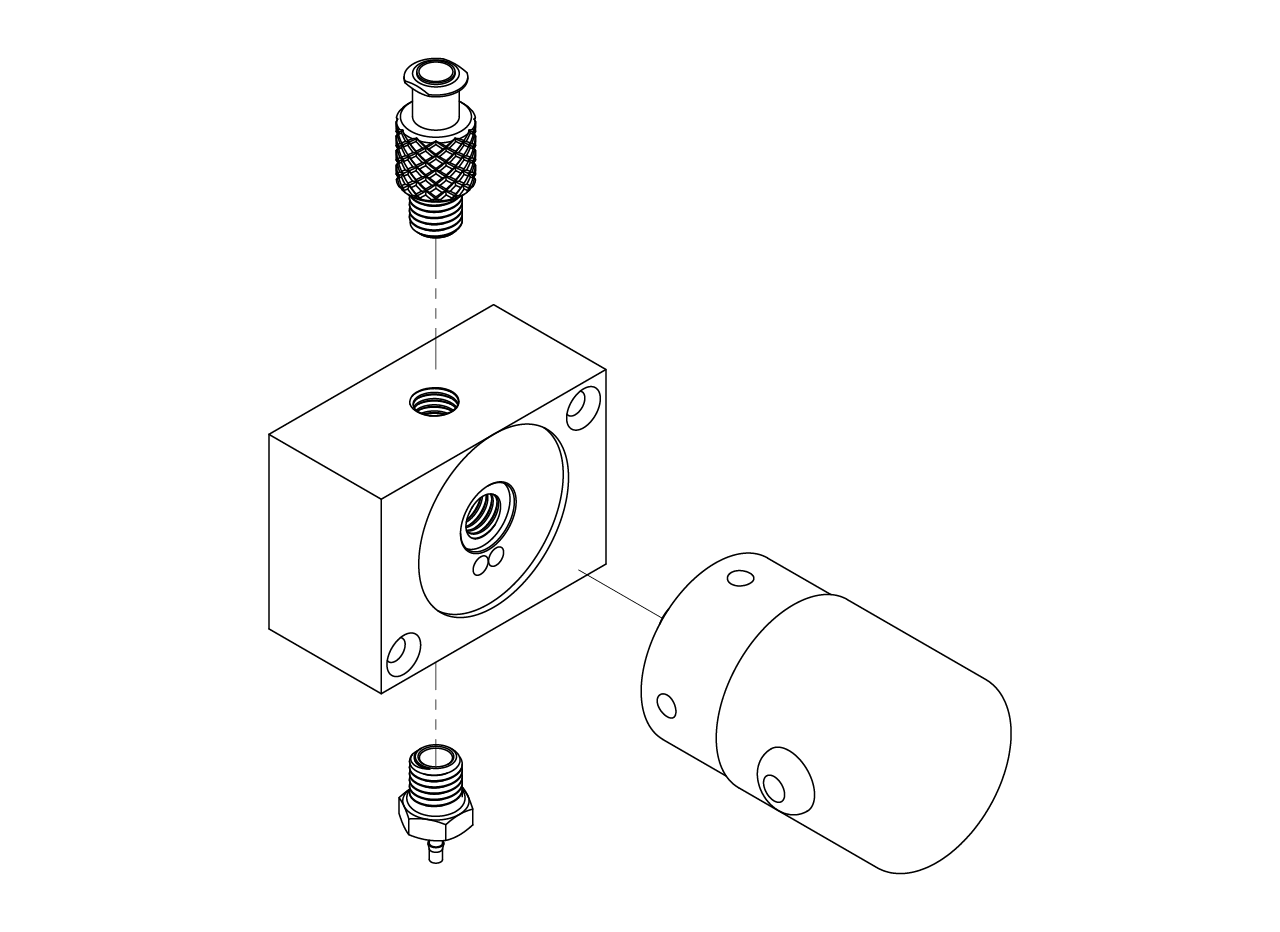
building/assets/images/reward/reward-assembly-1.png
