BrainCOGS/VRrigs-documentation/building/assets/images/reward/reward-assembly-2.png

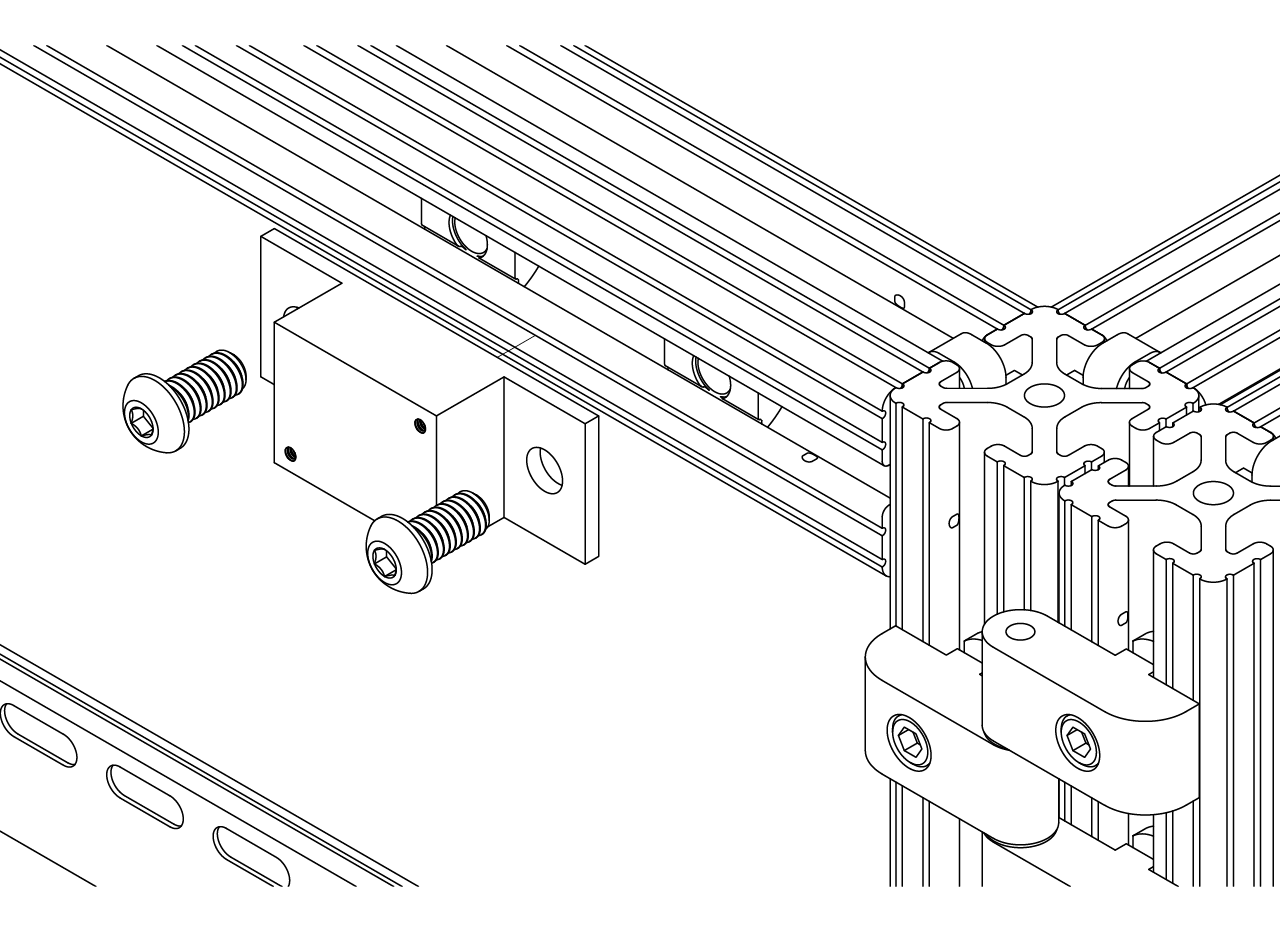
building/assets/images/reward/reward-assembly-2.png
