BrainCOGS/VRrigs-documentation/building/assets/images/reward/reward-assembly-3.png

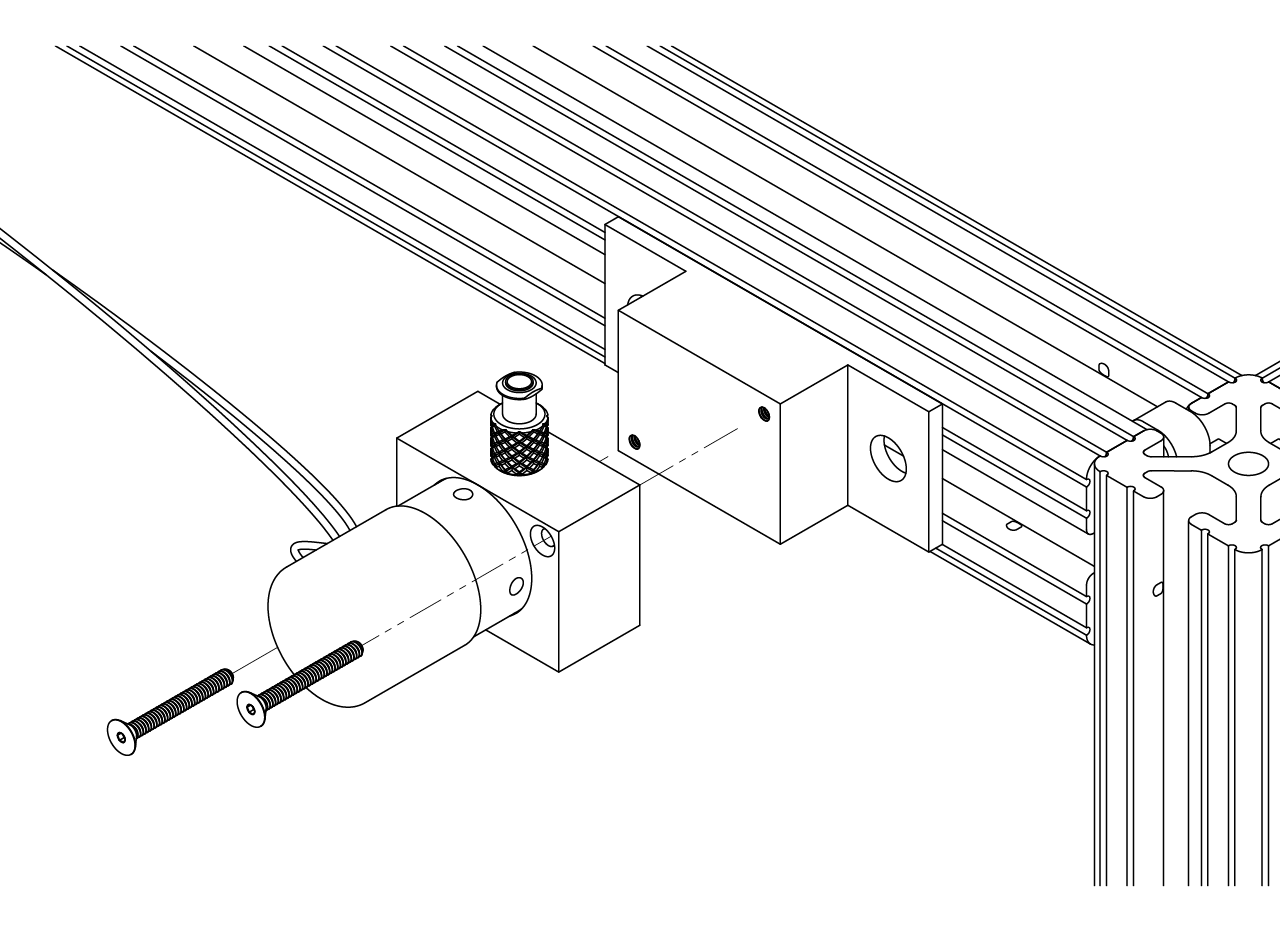
building/assets/images/reward/reward-assembly-3.png
