BrainCOGS/VRrigs-documentation/building/assets/images/reward/reward-assembly-4.png

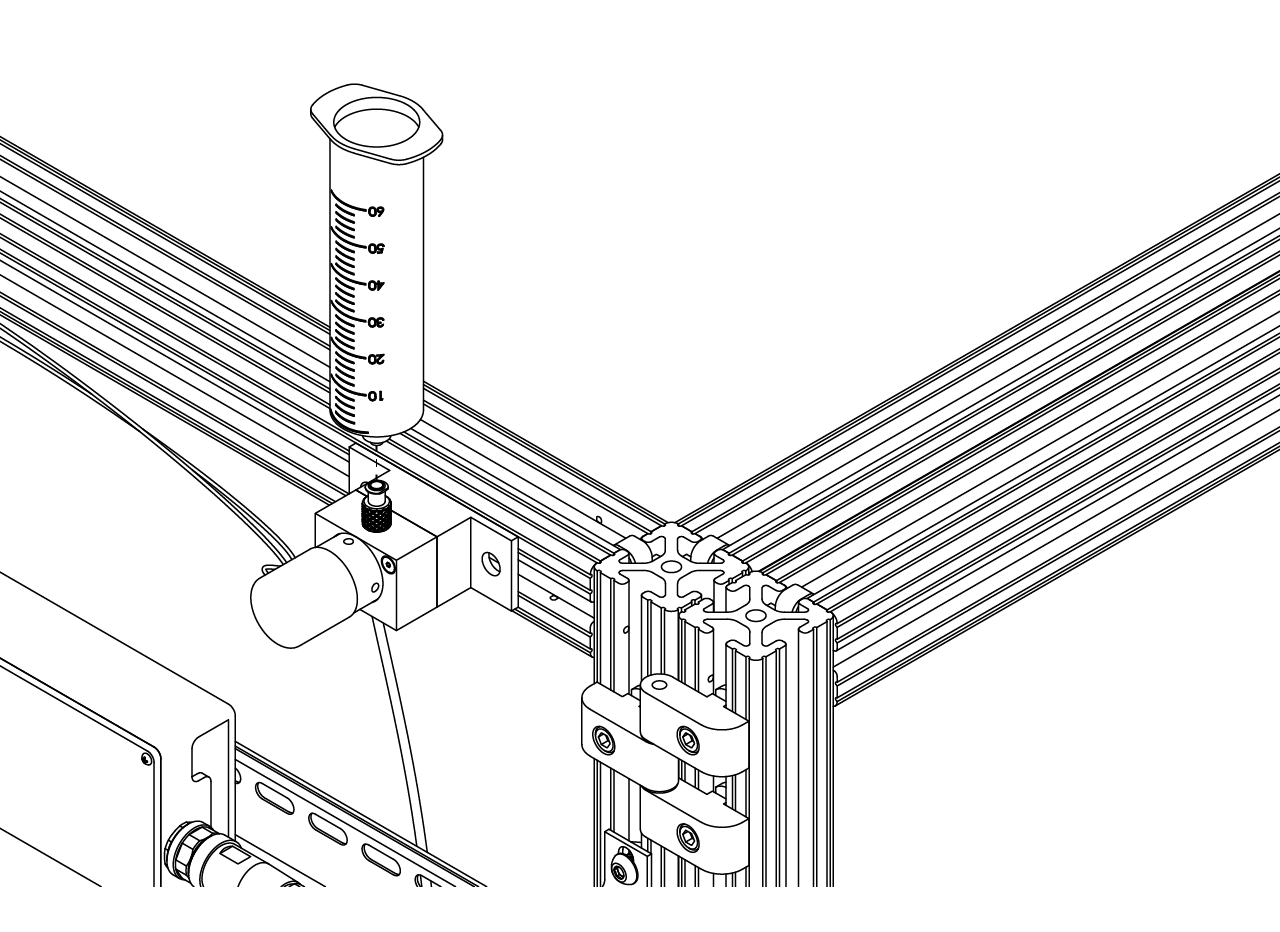
building/assets/images/reward/reward-assembly-4.png
