BrainCOGS/VRrigs-documentation/building/assets/images/reward/reward-description.png

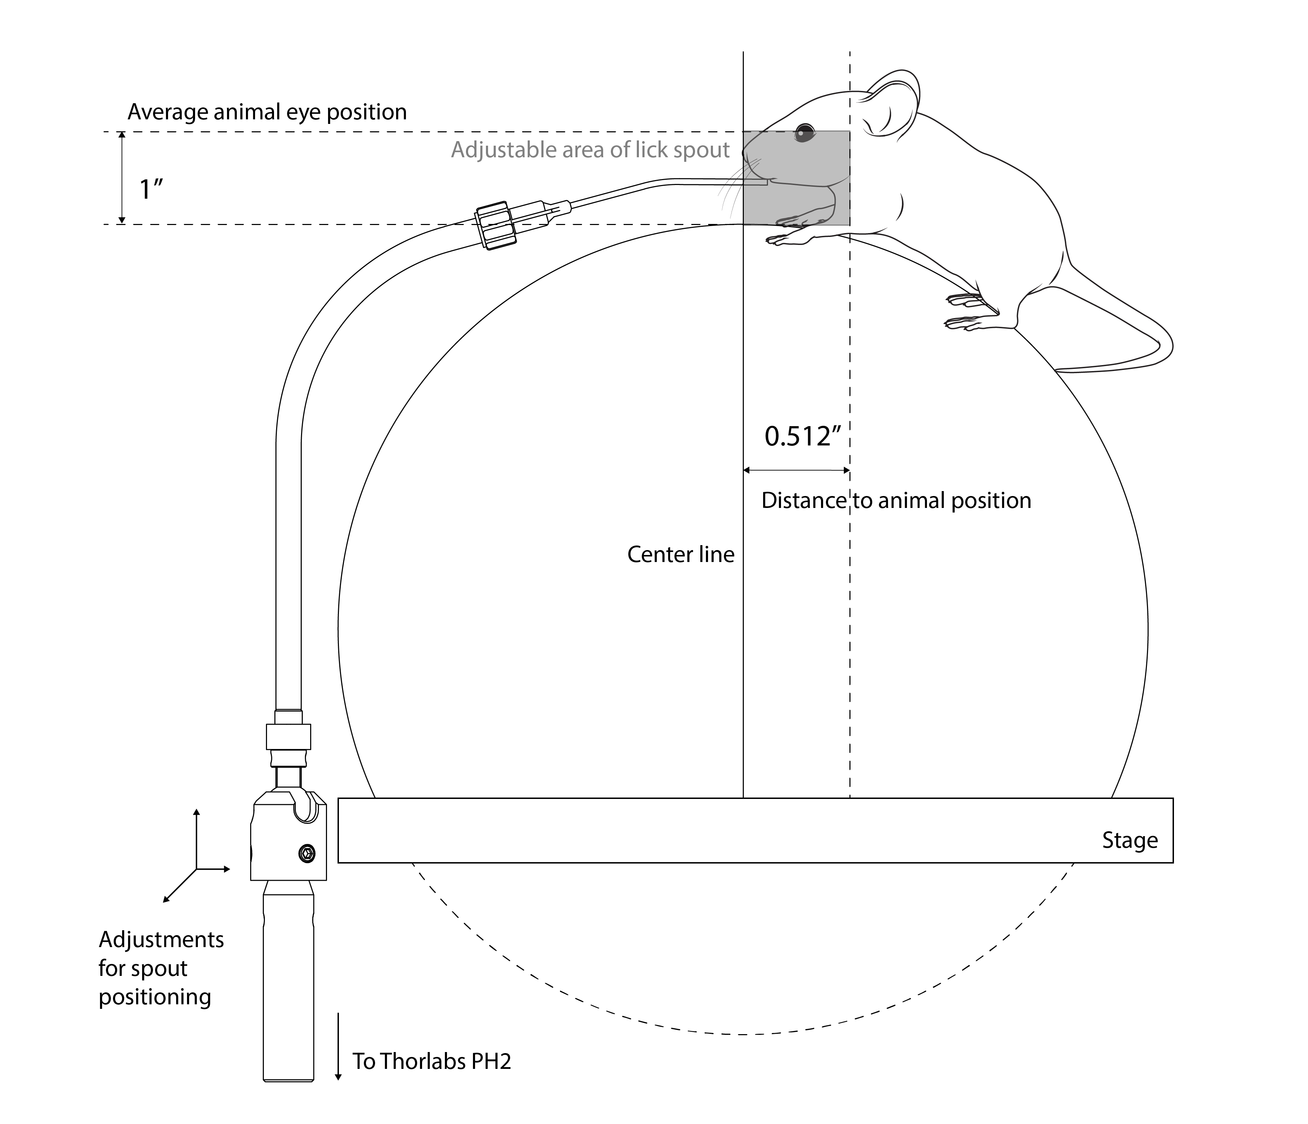
building/assets/images/reward/reward-description.png
