BrainCOGS/VRrigs-documentation/building/assets/images/stage/stage-construction-2.png

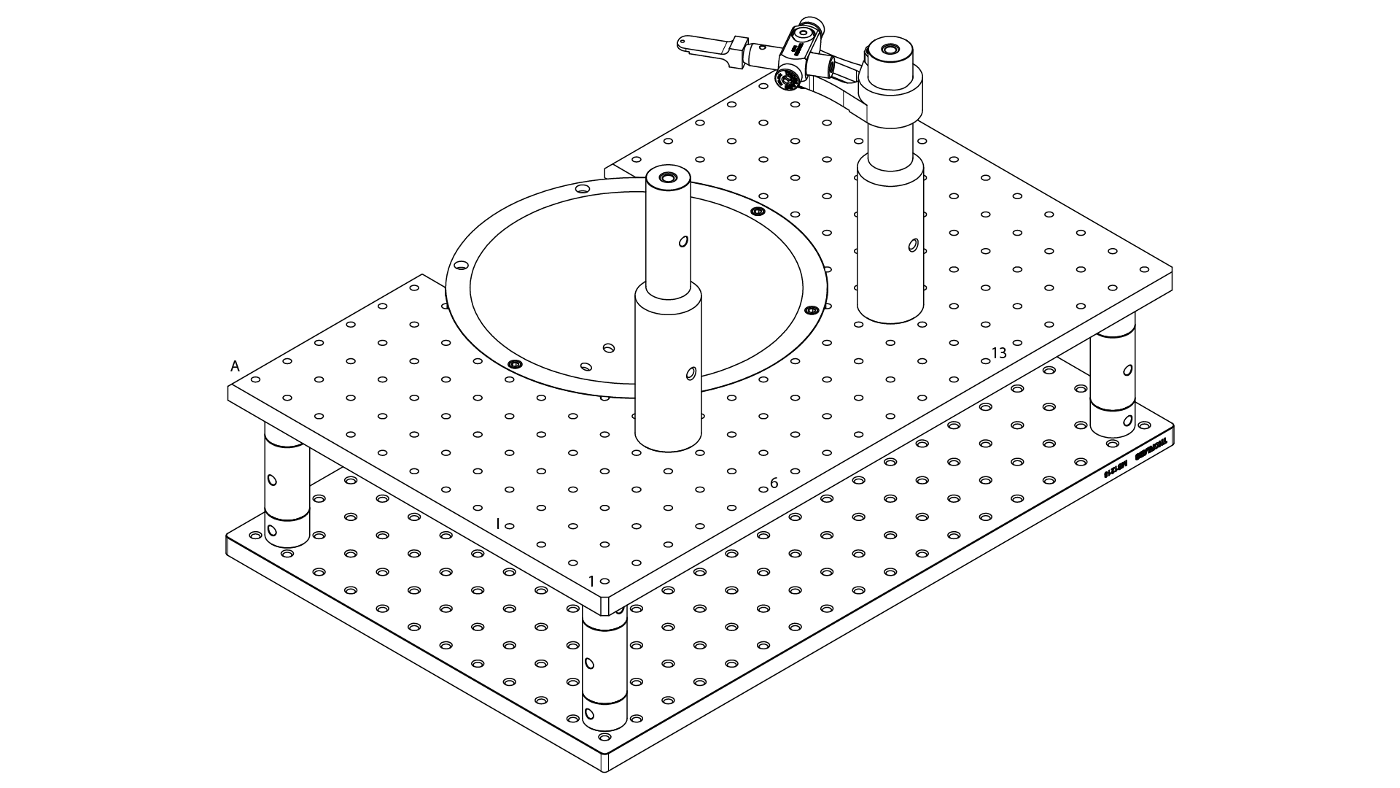
building/assets/images/stage/stage-construction-2.png
