BrainCOGS/VRrigs-documentation/building/assets/images/stage/stage-construction.png

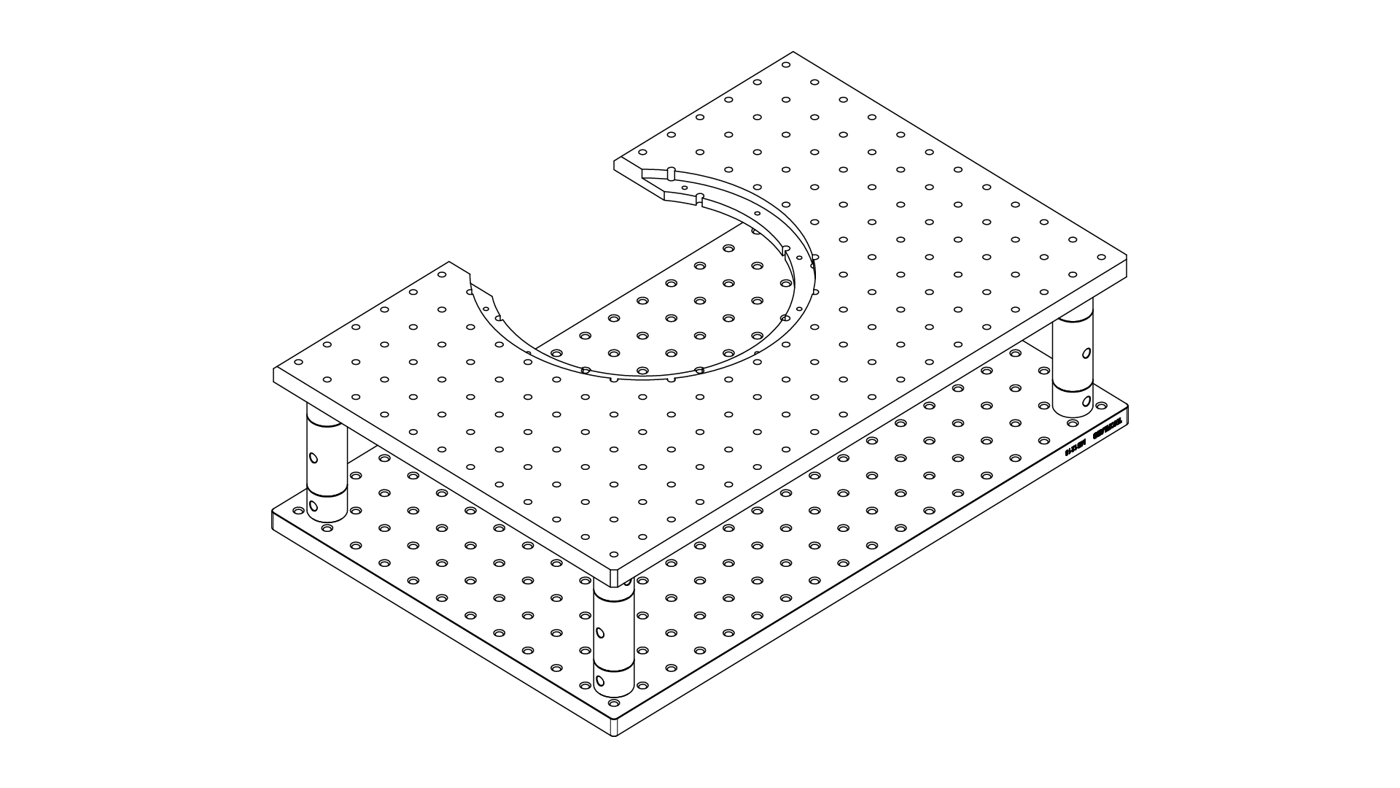
building/assets/images/stage/stage-construction.png
