BrainCOGS/VRrigs-documentation/software/assets/images/automation_gui/Installer_dialog.png

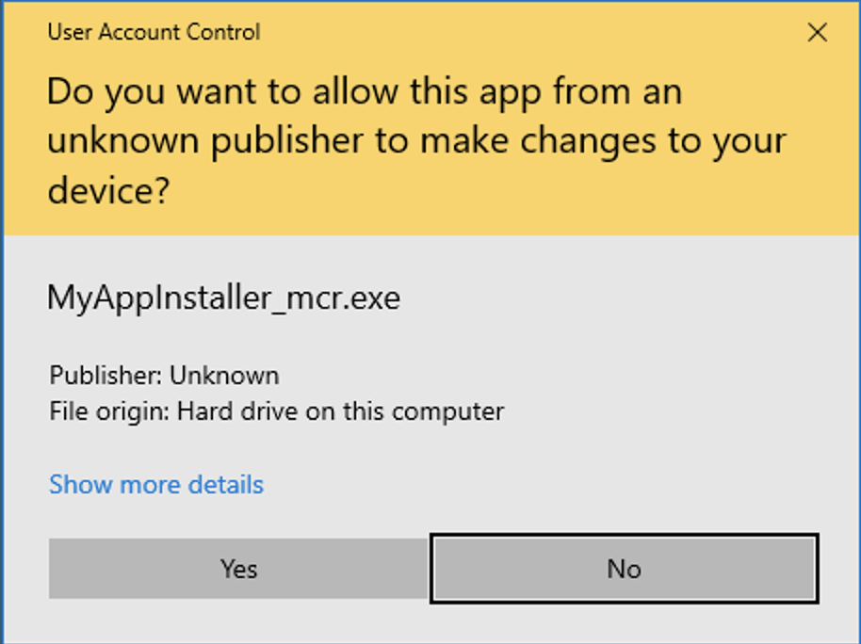
software/assets/images/automation_gui/Installer_dialog.png
