BrainCOGS/VRrigs-documentation/building/assets/pdf/air-puffs/control_manifold.pdf

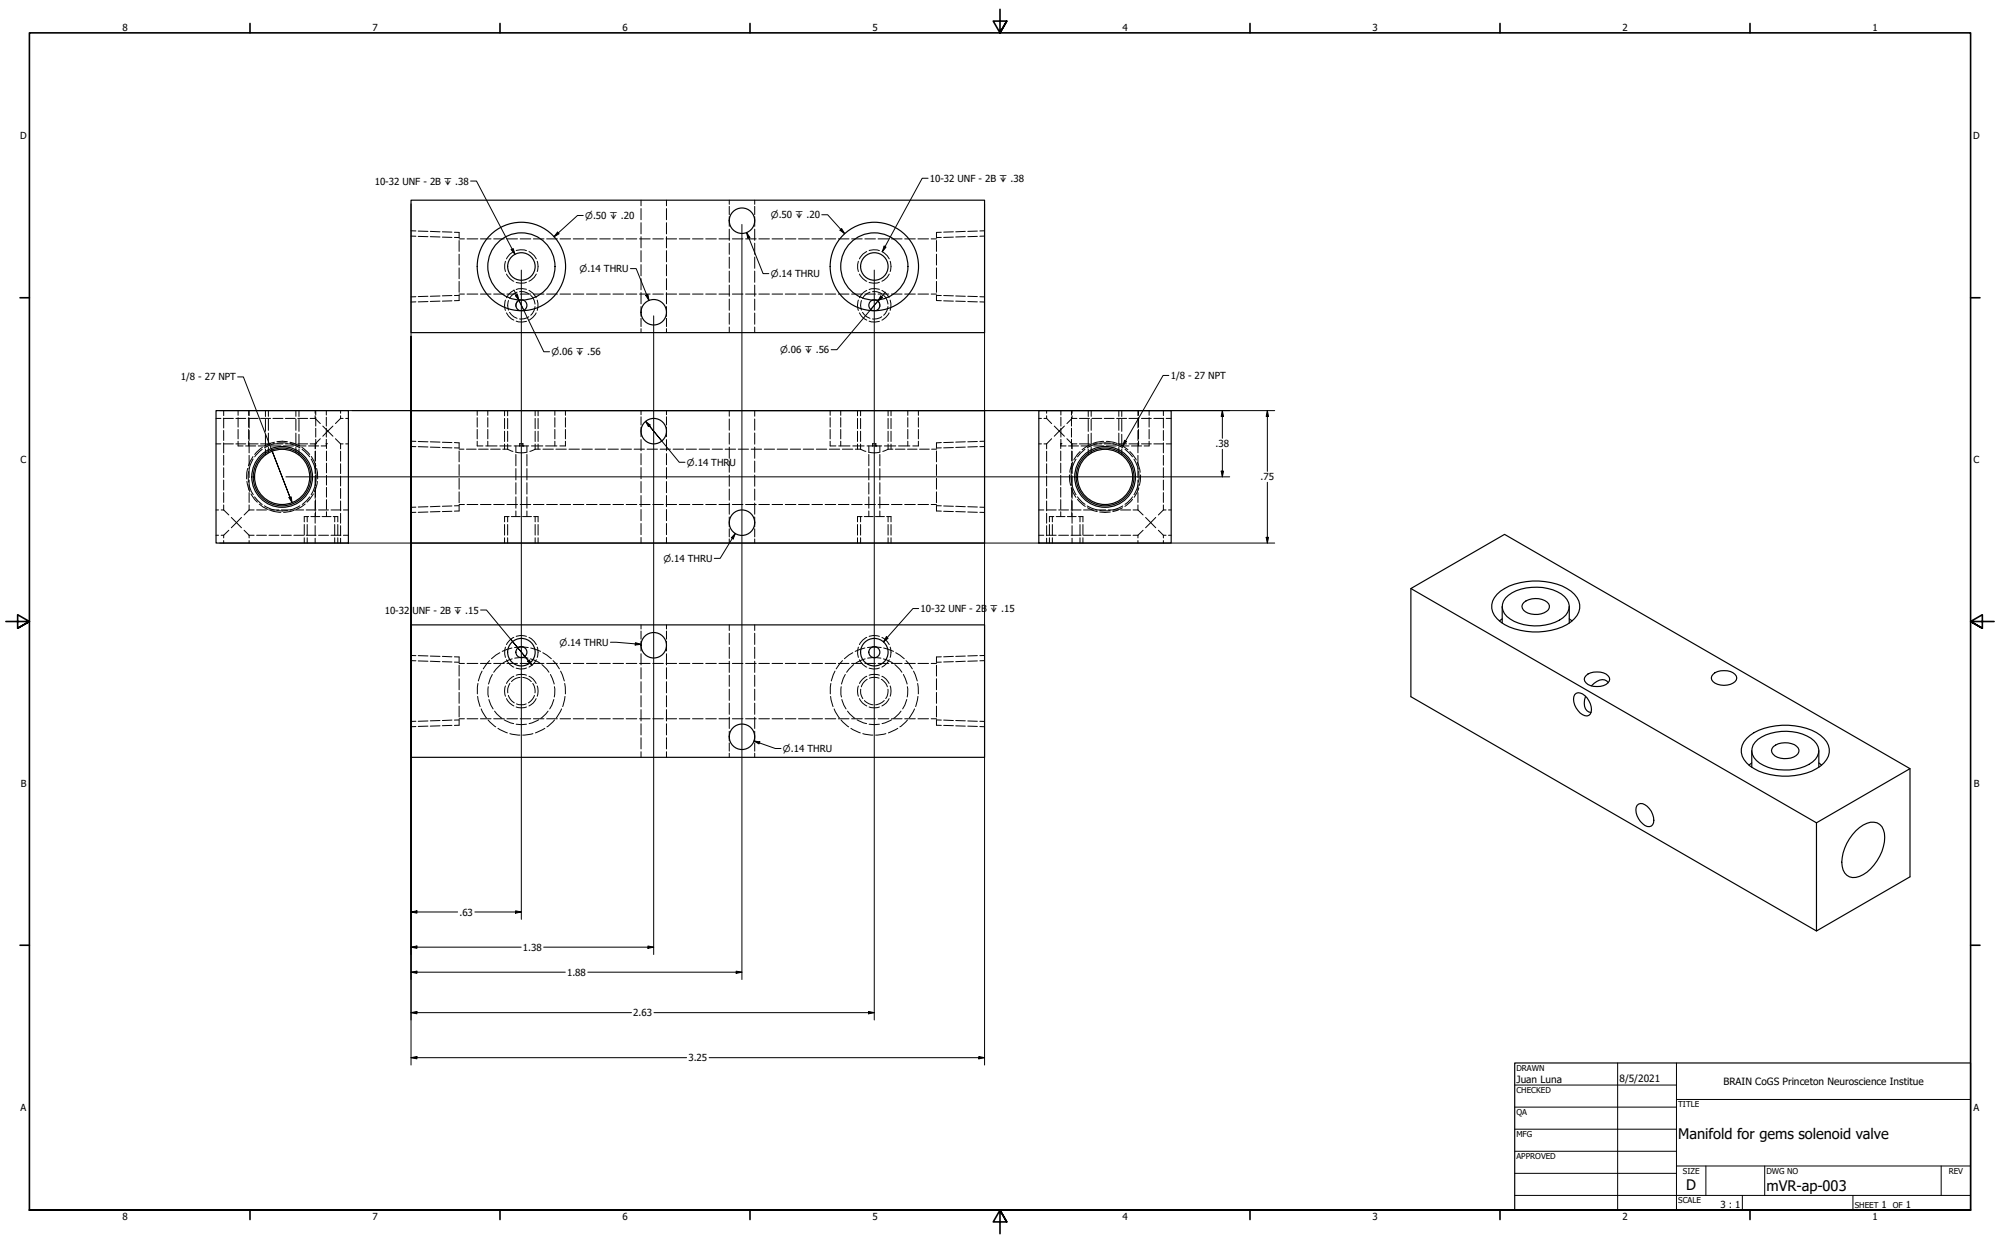
[picture p222: page 1]
1/8 - 27 NPT

DRAWN Juan Luna | 8/5/2021 | BRAIN CoGS Princeton Neuroscience Institue

CHECKED

Manifold for gems solenoid valve

MFG

APPROVED

SIZE D | DWG NO mVR-ap-003 | REV

SCALE 3 : 1 | | SHEET 1 OF 1
