BrainCOGS/VRrigs-documentation/building/assets/pdf/reward/stainless_steel_tube.pdf

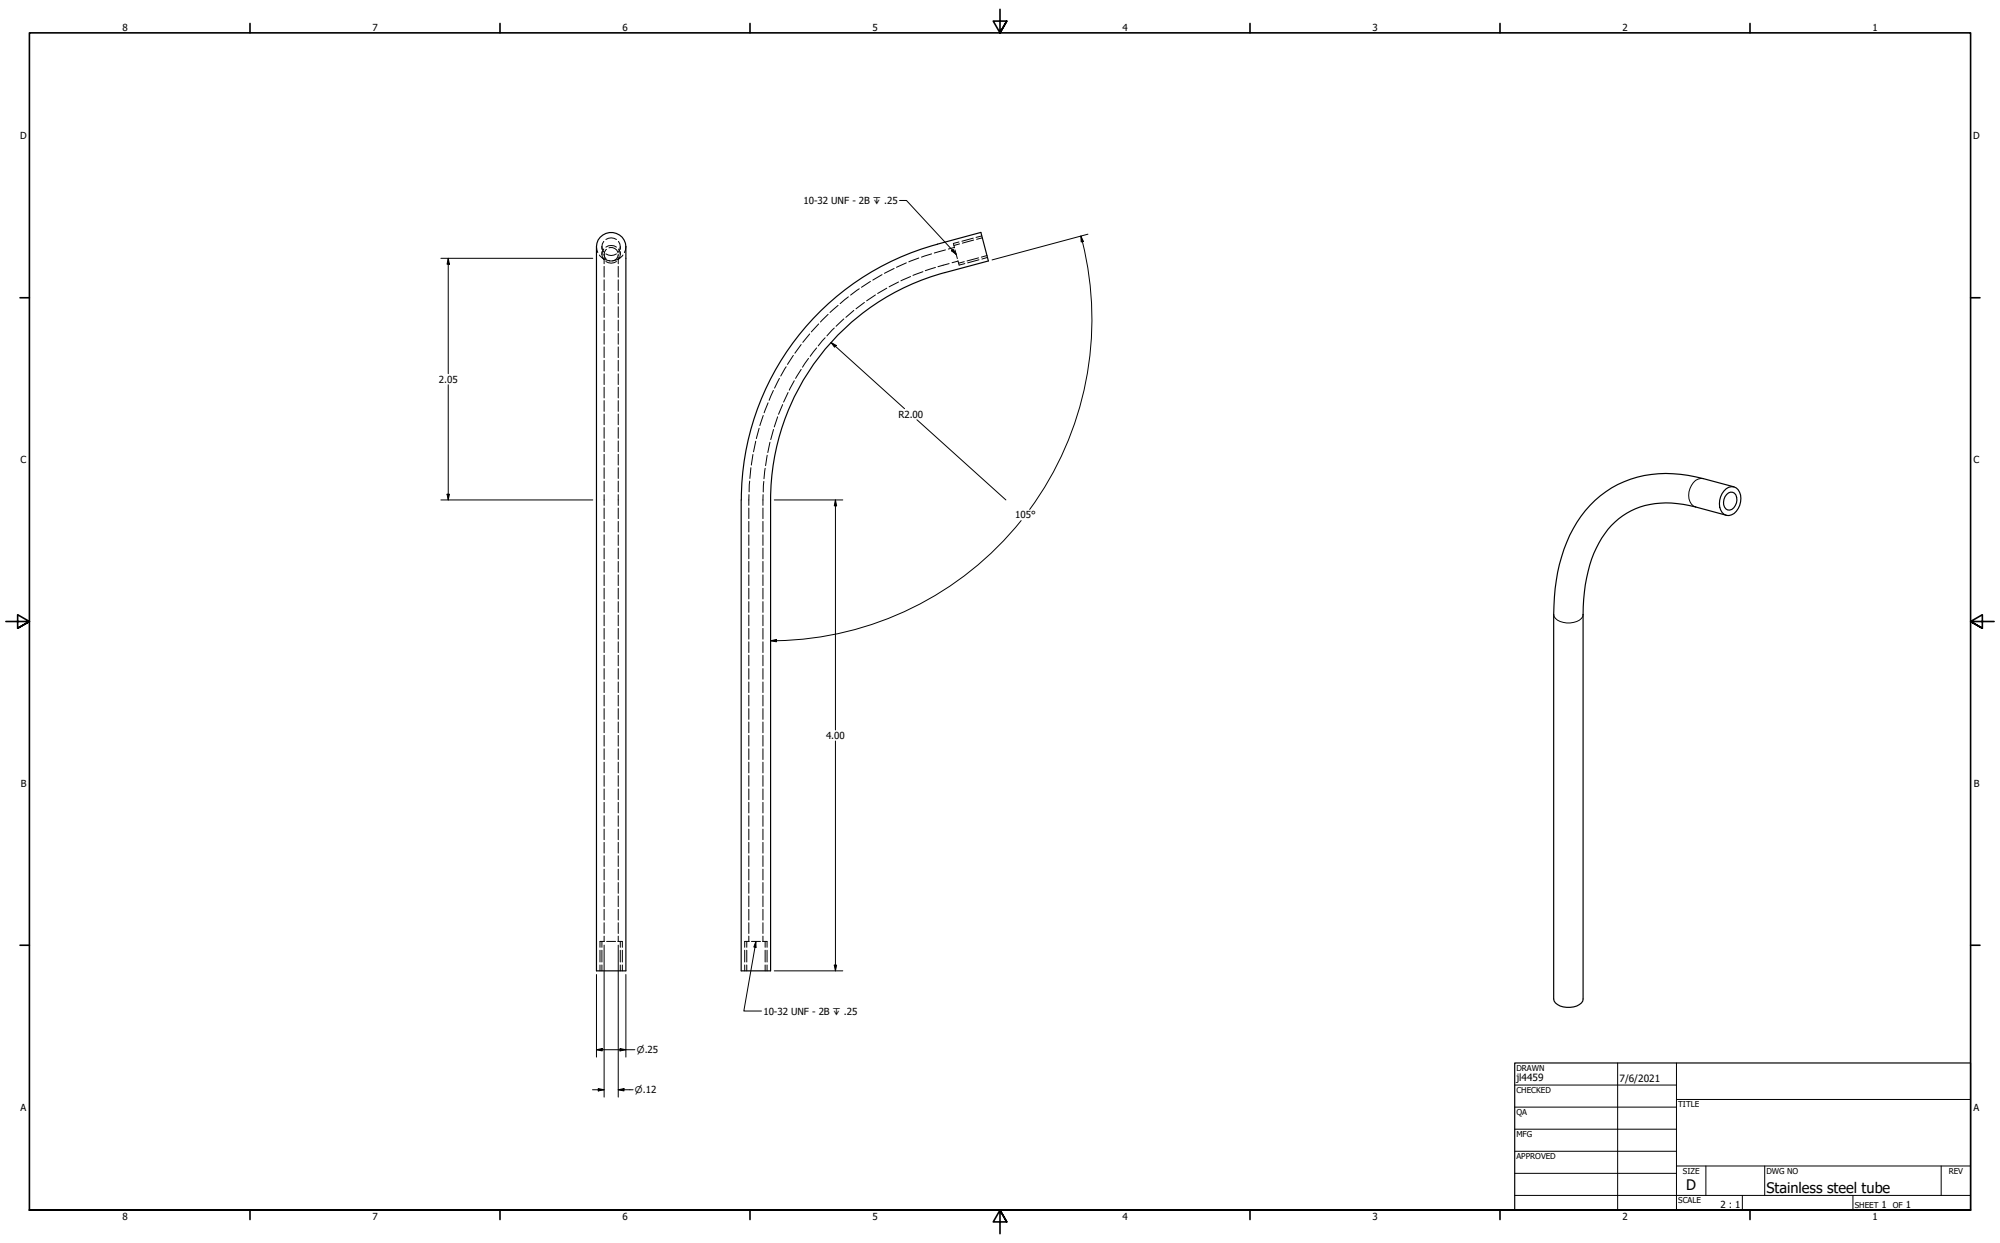
[picture p223: page 1]

DRAWN jl4459 | 7/6/2021

CHECKED

MFG

APPROVED

SIZE D | DWG NO Stainless steel tube | REV

SCALE 2 : 1 | | SHEET 1 OF 1
