BrainCOGS/VRrigs-documentation/building/assets/pdf/reward/tube_to_trb1_adapter.pdf

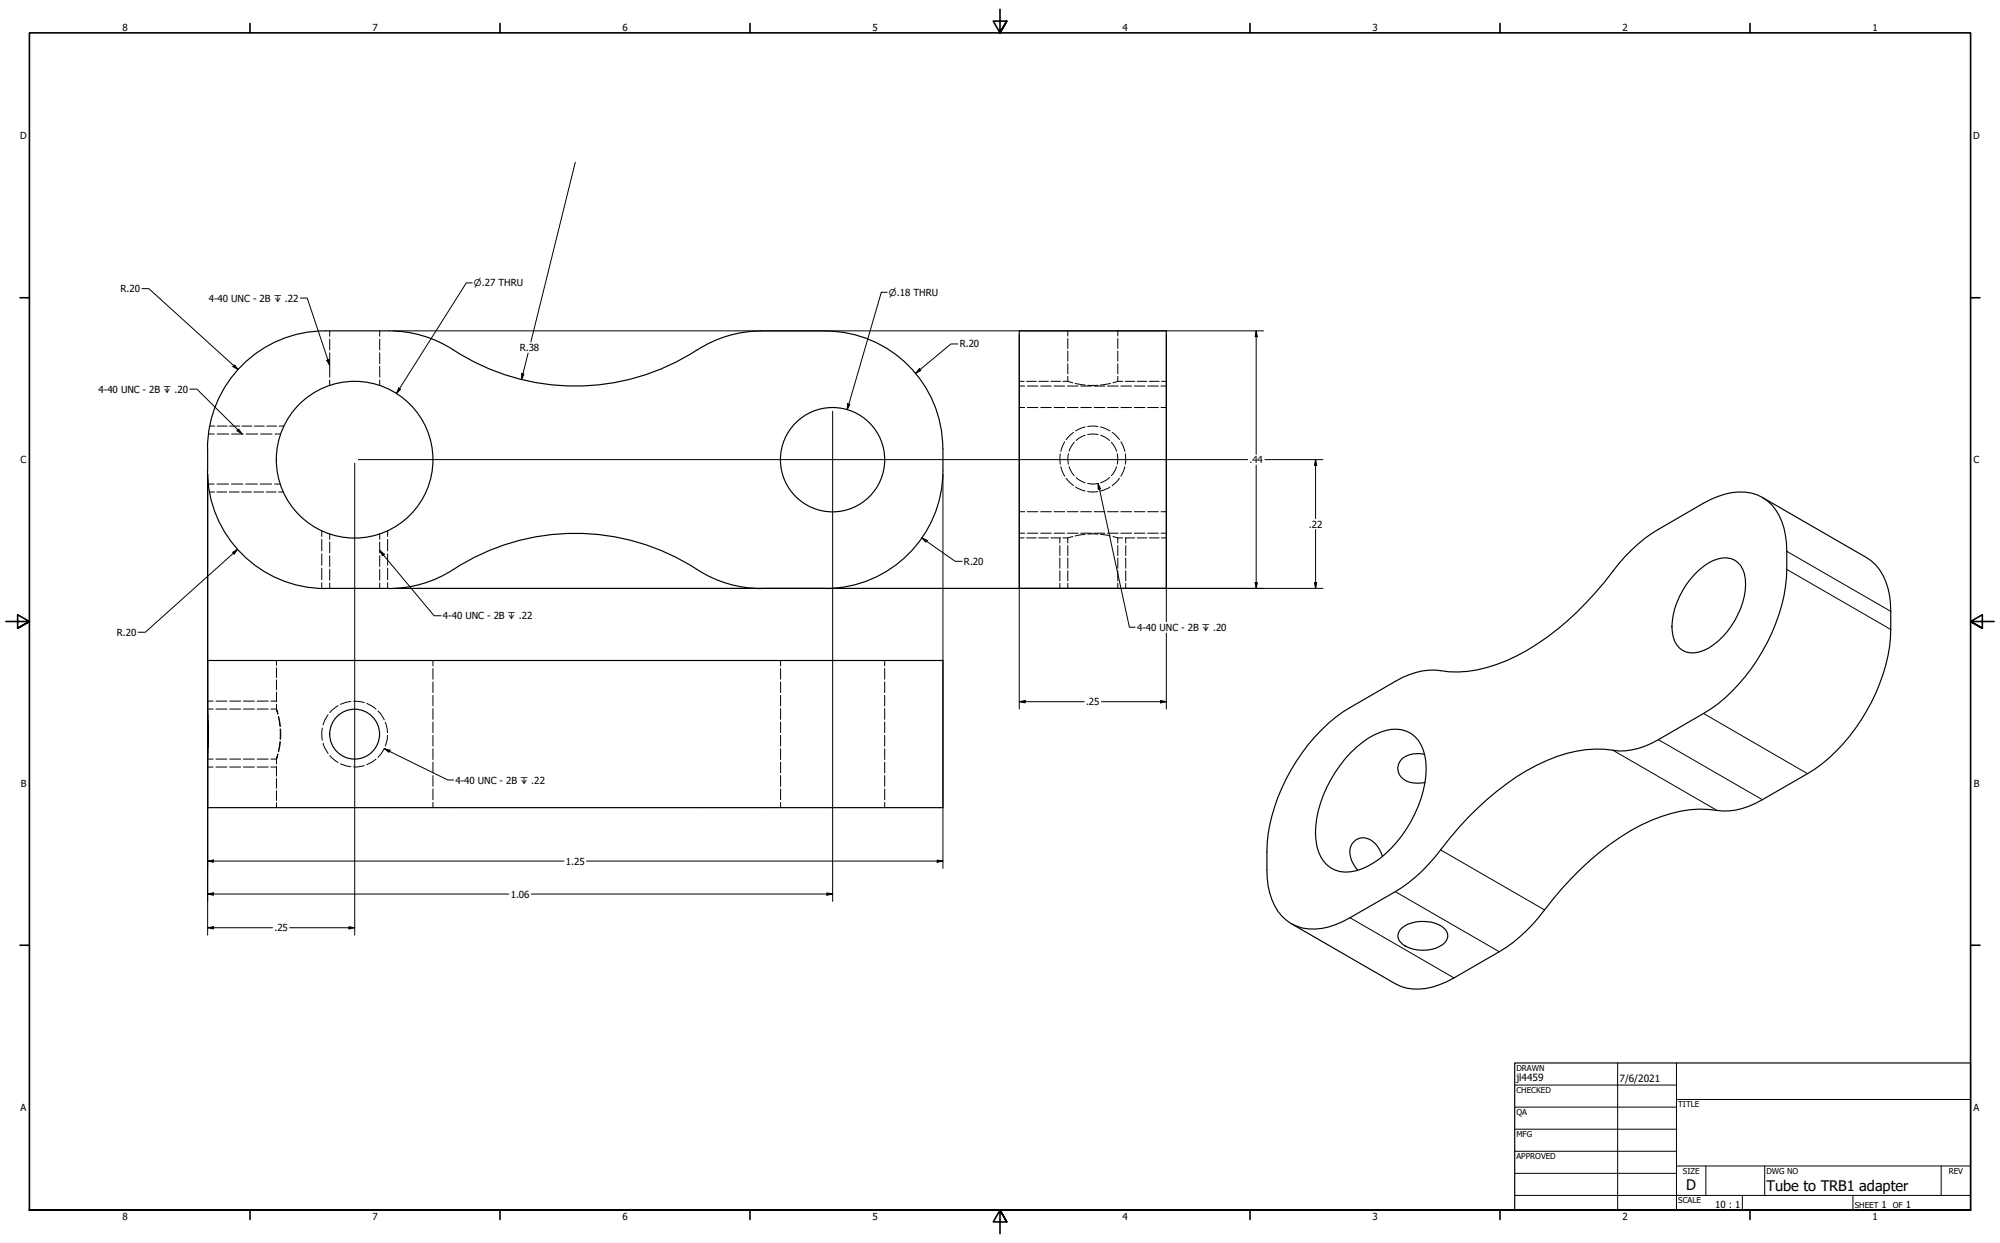
[picture p224: page 1]

DRAWN jl4459 | 7/6/2021

CHECKED

MFG

APPROVED

SIZE D | DWG NO Tube to TRB1 adapter | REV

SCALE 10 : 1 | | SHEET 1 OF 1
