BrainCOGS/VRrigs-documentation/building/assets/pdf/air-puffs/delivery_cover.pdf

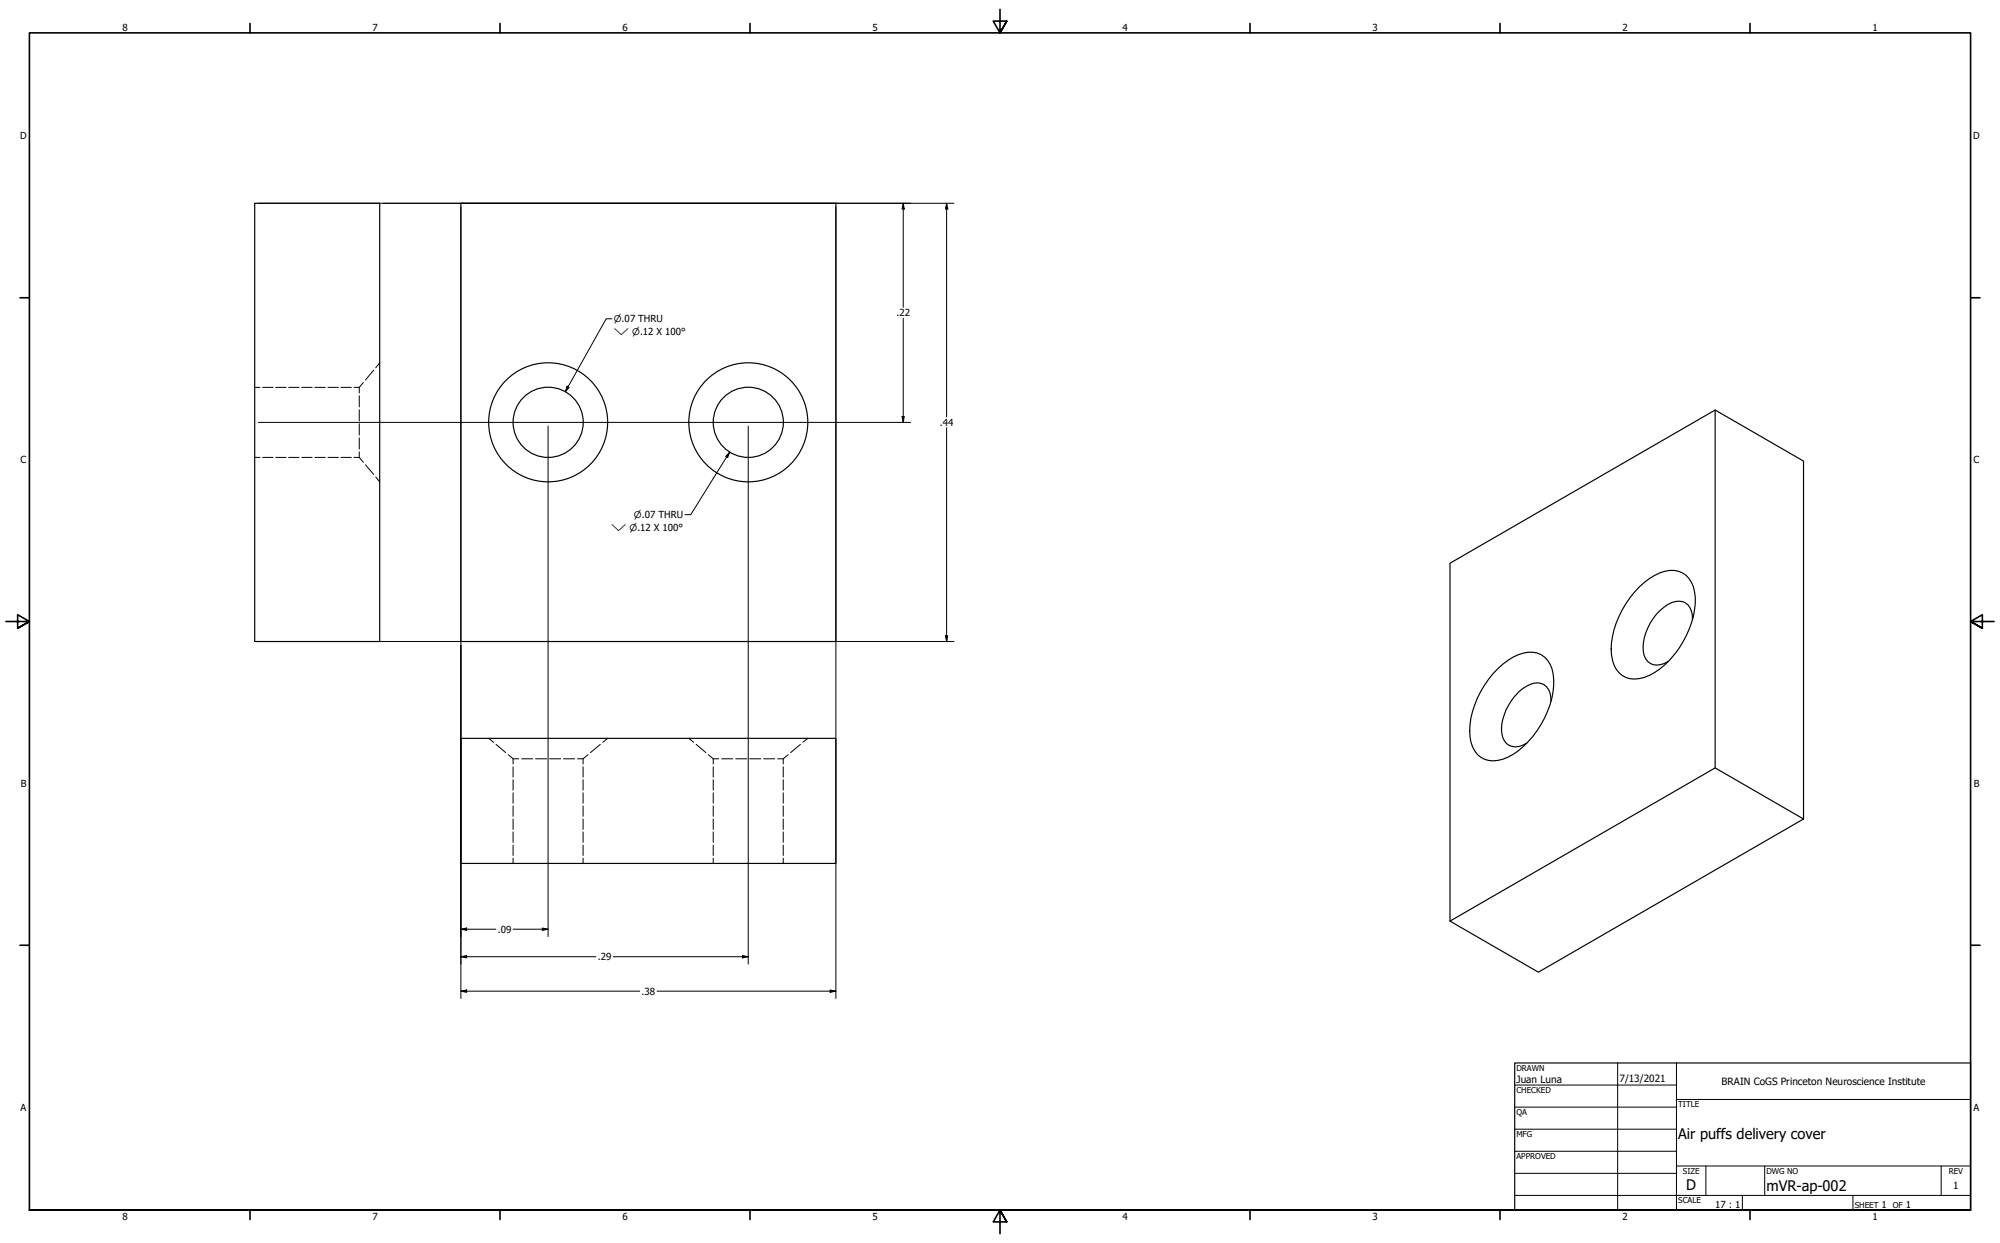
[picture p226: page 1]

DRAWN Juan Luna | 7/13/2021 | BRAIN CoGS Princeton Neuroscience Institute

CHECKED

Air puffs delivery cover

MFG

APPROVED

SIZE D | DWG NO mVR-ap-002 | REV 1

SCALE 17 : 1 | | SHEET 1 OF 1
