BrainCOGS/VRrigs-documentation/building/assets/pdf/positioning/positioning_tool_mini_vr.pdf

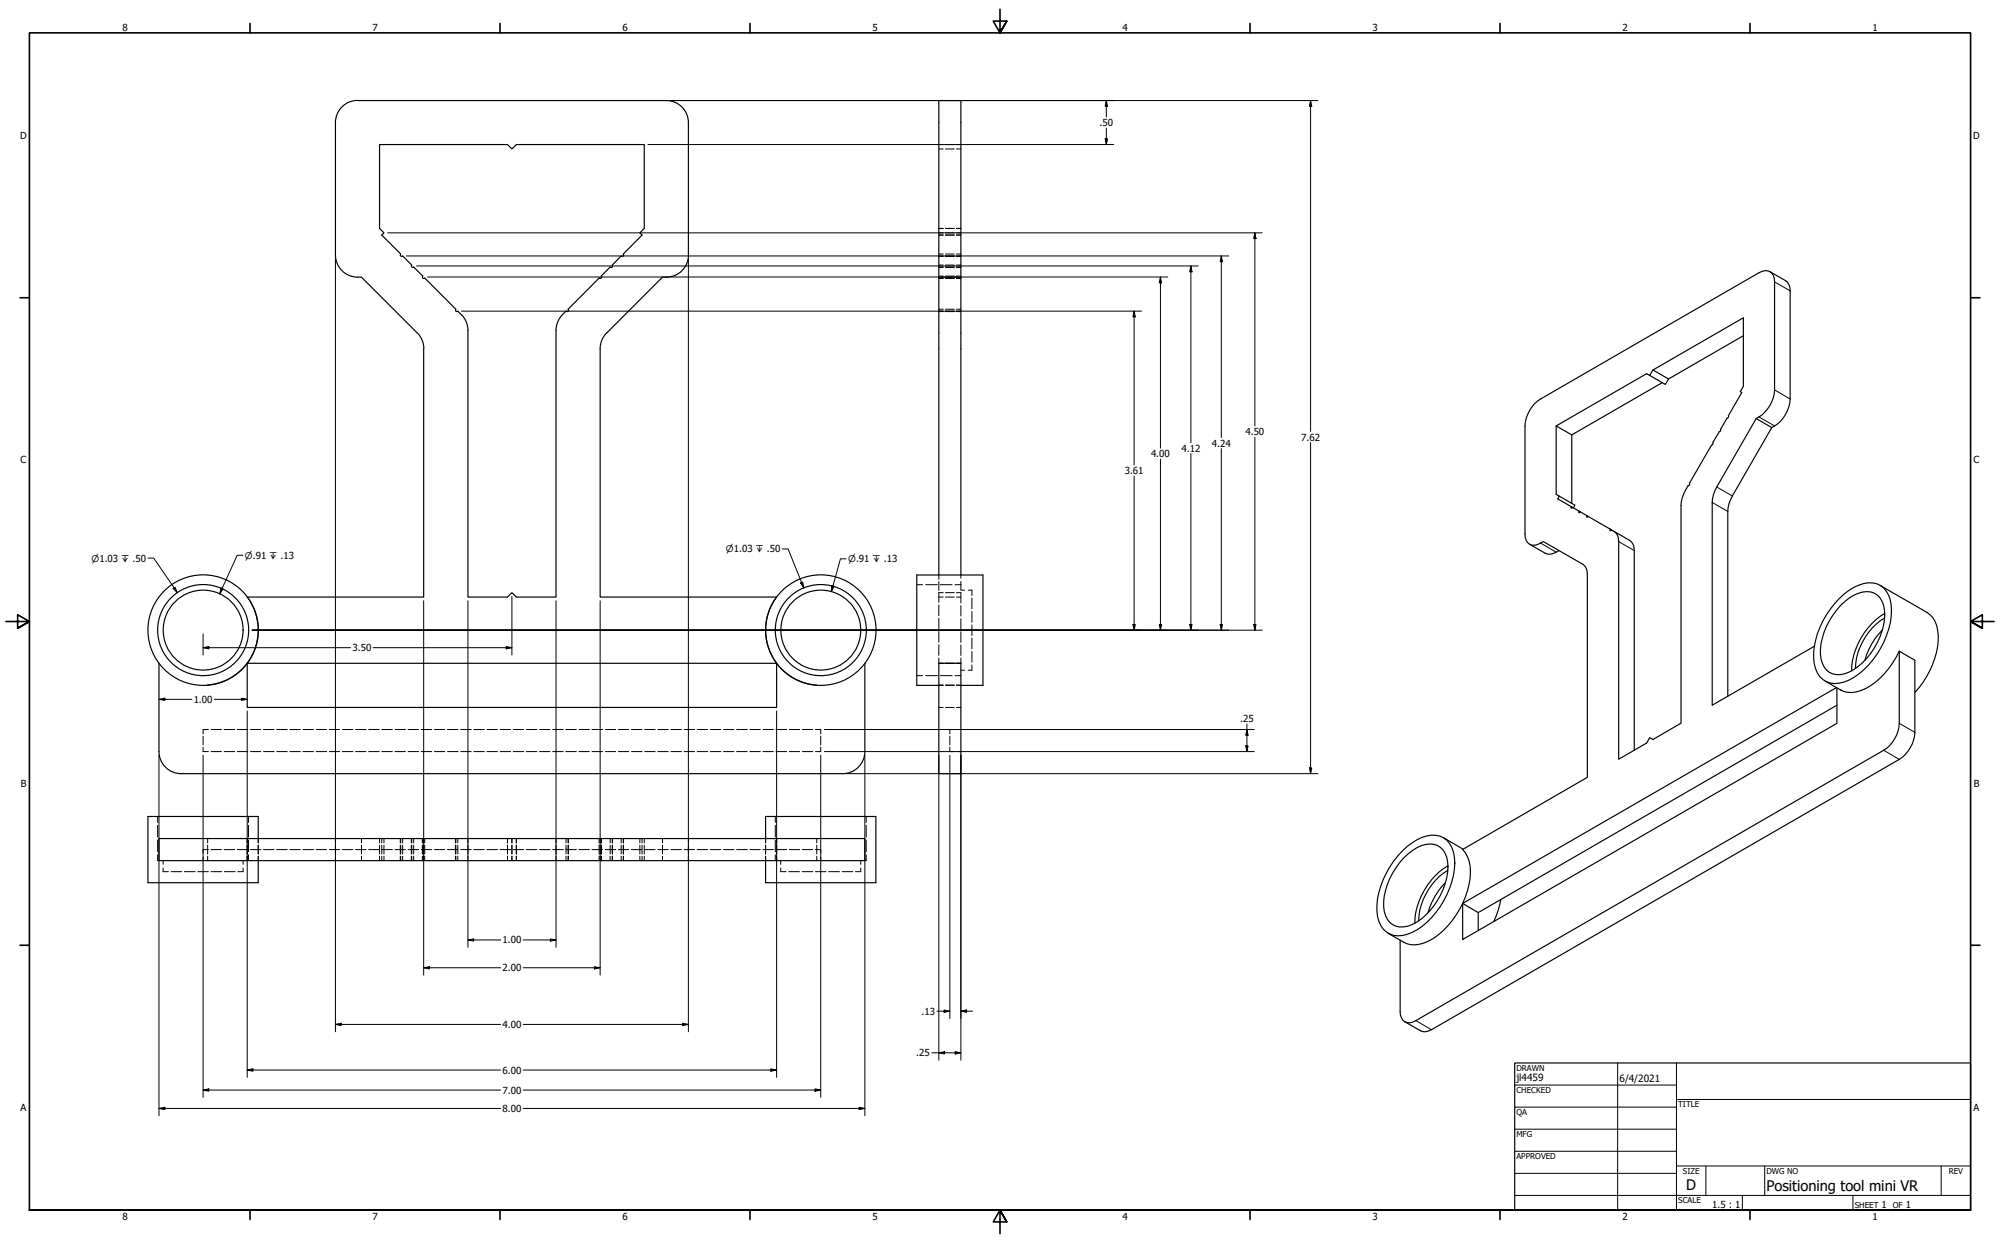
[picture p227: page 1]

DRAWN jl4459 | 6/4/2021

CHECKED

MFG

APPROVED

SIZE D | DWG NO Positioning tool mini VR | REV

SCALE 1.5 : 1 | | SHEET 1 OF 1
