BrainCOGS/VRrigs-documentation/(commit log)

2021-09-08 Initial commit - Positioning and reward
    [4406T110_MINIATURE STAINLESS STEEL BARBED TUBE FITTING.ipt, 51525K428_PLASTIC QUICK-TURN TUBE COUPLING.ipt, 5862K163_HIGH-PULL RARE EARTH MAGNETIC DISC.ipt, 91251A194_Black-Oxide Alloy Steel Socket Head Screw.ipt, 98535A136_1095 SPRING STEEL MACHINE KEY STOCK.ipt, Positioning tool mini VR.iam, Positioning tool mini VR.ipt, Reward spout.iam]
2021-09-08 folder structure change
    [4406T110_MINIATURE STAINLESS STEEL BARBED TUBE FITTING.ipt, 51525K428_PLASTIC QUICK-TURN TUBE COUPLING.ipt, 5862K163_HIGH-PULL RARE EARTH MAGNETIC DISC.ipt, 91251A194_Black-Oxide Alloy Steel Socket Head Screw.ipt, 98535A136_1095 SPRING STEEL MACHINE KEY STOCK.ipt, Positioning tool mini VR.iam, Positioning tool mini VR.ipt, Reward spout.iam]
2021-09-10 Air puffs documentation added
    [1162T370_ZINC PLATED STEEL FITTINGS WITH SEALANT.ipt, 2227T21_Miniature Precision Compressed Air Regulator.ipt, 2227T41_Mounting Bracket for Inline Mount 1 8 NPT Miniature Precision Compressed Air Regulator.ipt, 2227T420_PRECISION NPT THREAD MINIATURE AIR REGULATOR.ipt, 2844K110_NICKEL-PLTD BRASS BARBED VACUUM TUBE FITTING.ipt, 5047K110_MOISTURE-RESISTANT ACETAL BARBED TUBE FITTING(1).ipt, 5648K2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]
2021-09-16 add stage to documentation
2021-09-16 Add stage construction
2021-09-28 remove dist folder from gitignore
    [positioning_tool_mini_vr.stp]
2021-10-01 add second part of stage construction
2022-06-27 upgrade packages
    [positioning_tool_mini_vr.stp]
2022-06-27 build repo
    [positioning_tool_mini_vr.stp]
2022-09-19 Stage modifications
2022-09-20 cup assembly instruction added
2022-09-21 Add cup assembly pictures and format to stage module
2022-09-23 Add to stage, cup and bottom plate assembly documentation
2022-09-26 add GERBER files for IR LED PCB
2022-09-26 Add stage assembly instructions and gerber files for IR LED PCB
2022-09-27 Add carrier assembly instructions.
2022-10-03 add mirror assembly, projector assembly and screen assembly to projection module
2022-10-25 Add info to stage docs
2023-01-11 motor gui IMAGE
2023-08-01 Finish control module assembly instructions
2023-08-03 Update to the rig assembly instructions
2023-08-03 update to the stage docs
2023-08-09 Update air supply module - replace main air connector
2023-08-10 add PCB link to control module
2023-08-14 projection calibration and maintenance added
2023-08-17 Add stage maintenance and troubleshooting
2023-09-27 Add values to the resistors in control module
2023-11-15 Add arduino programming to control documentation
2024-01-17 stage updates
2024-12-30 update to vuepress 2 before fixing minor stuff
    [1162T370_ZINC PLATED STEEL FITTINGS WITH SEALANT.ipt, 2227T21_Miniature Precision Compressed Air Regulator.ipt, 2227T41_Mounting Bracket for Inline Mount 1 8 NPT Miniature Precision Compressed Air Regulator.ipt, 2227T420_PRECISION NPT THREAD MINIATURE AIR REGULATOR.ipt, 2844K110_NICKEL-PLTD BRASS BARBED VACUUM TUBE FITTING.ipt, 4406T110_MINIATURE STAINLESS STEEL BARBED TUBE FITTING.ipt, 5047K110_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]
2026-04-15 updated .vuepress
    [positioning_tool_mini_vr.stp]
2026-07-21 Test Laser GUI added
2026-08-14 fix(deps): resolve dependabot security alerts in yarn.lock
    Force patched versions of vulnerable devDependencies (direct and
    transitive) via yarn resolutions/version bumps to close open
    Dependabot alerts: postcss, js-yaml, fast-uri, nanoid, undici,
    webpack, webpack-dev-server, shell-quote, svgo, linkify-it,
    immutable, websocket-driver, @babel/core,
    @babel/plugin-transform-modules-systemjs, follow-redirects,
    http-proxy-middleware, launch-editor, lodash, markdown-it,
    on-headers, picomatch, qs, serialize-javascript, and uuid.
    All affected packages are build-time dependencies of the VuePress
    toolchain. Verified `yarn build` and `yarn dev` both still succeed.
    Assisted-by: ClaudeCode:claude-sonne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
2026-08-17 docs: fix broken link and formatting artifacts in virmen developer docs (#22)
    * docs: fix broken link and formatting artifacts in virmen developer docs
    Fixes issues introduced in the "New virmen developer stuff" commit:
    - Repoint the dead ./virmen_guide.md#protocol-file anchor to the
    existing #new-task-creation section, since virmen_guide.md has no
    "Protocol File" heading.
    - Remove a stray empty "####" heading and an orphaned trailing path
    (Z:\Shared\TasksScheduler) left over in virmen_developer.md.
    - Normalize inconsistent leading-space heading indentation in
    automated_cronjobs.md.
    Assisted-by: ClaudeCode:claude-sonnet-5
    * docs: fix grammar and tighten wording in virmen developer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
2026-08-20 Revert "docs: fix broken link and formatting artifacts in virmen developer do…" (#25)
    This reverts commit 16f39d6dca77c8ff59d86a36da383793d649b589.
2026-08-20 Revert "Revert "docs: fix broken link and formatting artifacts in virmen deve…" (#26)
    This reverts commit dd0453ea0e28aefa5de217e33ddd82e9f9c421f9.
2026-08-20 fix: strip embedded BOM from production CSS breaking published site (#27)
    @vuepress/highlighter-helper ships whitespace.css with a leading UTF-8
    BOM. mini-css-extract-plugin concatenates CSS chunks verbatim during
    `vuepress build`, so that BOM lands mid-file directly before the theme's
    core `:root { --c-brand: ...; --navbar-height: ...; }` rule. Browsers
    treat the corrupted " :root" as an unrecognized selector and drop
    the whole block, breaking layout and theming on the published site.
    `vuepress dev` never concatenates CSS (styles are injected via <style>
    tags per module), so the bug was invisible locally and only showed up
    in production builds.
    Add a postbuild step that strips any embed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
2026-08-20 chore: stop tracking generated .vuepress/dist output (#28)
    * fix: strip embedded BOM from production CSS breaking published site
    in produc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
2026-08-20 test: add regression test for embedded CSS BOM (#29)
    in production b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
2026-08-20 test: add homepage visual-regression check and PR/push CI (#32)
    * test: add structural visual-regression check for the homepage
    test-css-bom.js catches one specific corruption mechanism (an embedded
    BOM). This adds a broader net using Playwright: it renders the actual
    built homepage in a real browser and asserts the layout facts that
    only hold when the theme's CSS truly applied — --navbar-height and
    --c-brand resolve to non-empty values, the navbar is visible and fixed
    to the top, and the hero heading doesn't overlap it (the exact visual
    symptom reported for #27, where the site title and page heading
    rendered stacked on top of each other).
    Deliberately avoids screenshot/pixel diffing: no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
2026-10-05 build: migrate the docs site to VitePress 2 and track Node LTS (#45)
    Replace VuePress 2 rc.31 with VitePress 2.0.0-alpha.20 (same pages, URLs, images and anchors; sidebar labels from frontmatter titles; green brand kept). CI and Docker track the current Node LTS (lts/*, node:lts). Fix image captions dropped from the static HTML (<center>), nested links from linkify, and near-invisible transparent drawings in dark mode; check every page for hydration errors.
    Assisted-by: ClaudeCode:claude-opus-5-5
2026-10-06 docs: Markdown figures, landing page refresh and a grammar pass (#47)
    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
2026-10-15 ci: scan the commits of the PR with gitleaks
    The gitleaks hook ran `gitleaks git --pre-commit --staged`. In CI,
    `prek run --all-files` runs on a fresh checkout with nothing staged, so
    the hook passed without scanning anything.
    The hook's entry is now .github/scripts/gitleaks-changes.sh. On commit it
    scans the staged changes (a merge commit: only what it introduces itself).
    In CI the general prek step skips gitleaks and a dedicated step runs it
    with GITLEAKS_BASE set to the PR base (or the commit before a push), so
    every commit of the PR is scanned, plus the lines merge commits introduced.
    A run without a base (workflow_dispatch) scans the whole history.
    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
